salvogendut/picolino-CPC/docs/images/picolino-cpc-top.png

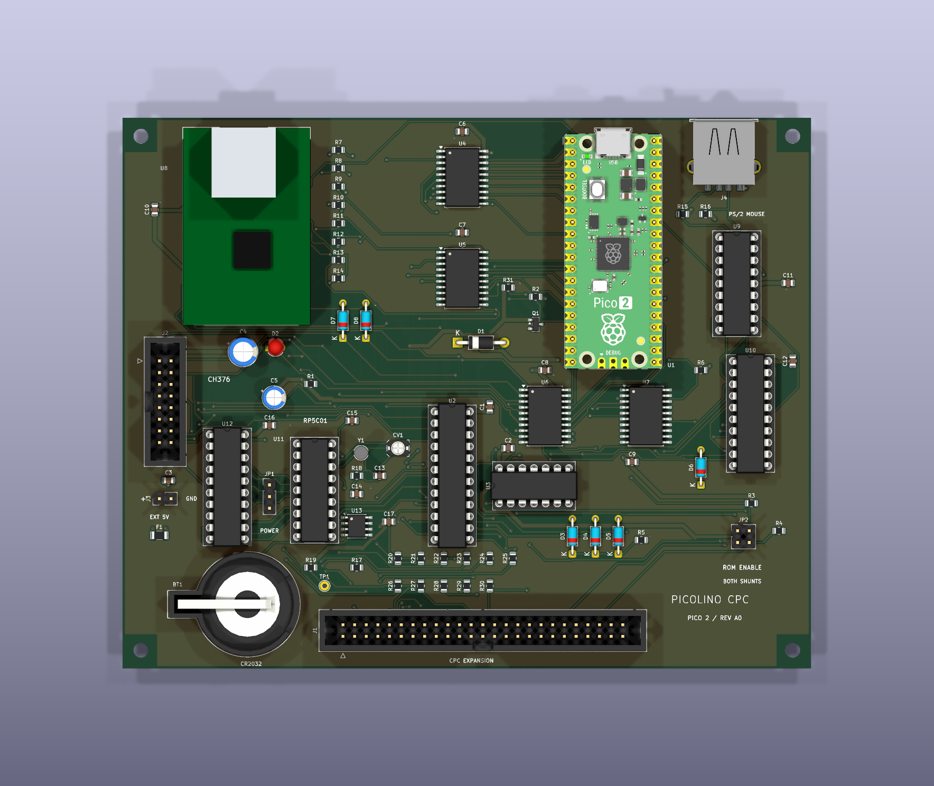
docs/images/picolino-cpc-top.png
