salvogendut/picolino-CPC/hardware/kicad/picolino-cpc-schematic.pdf

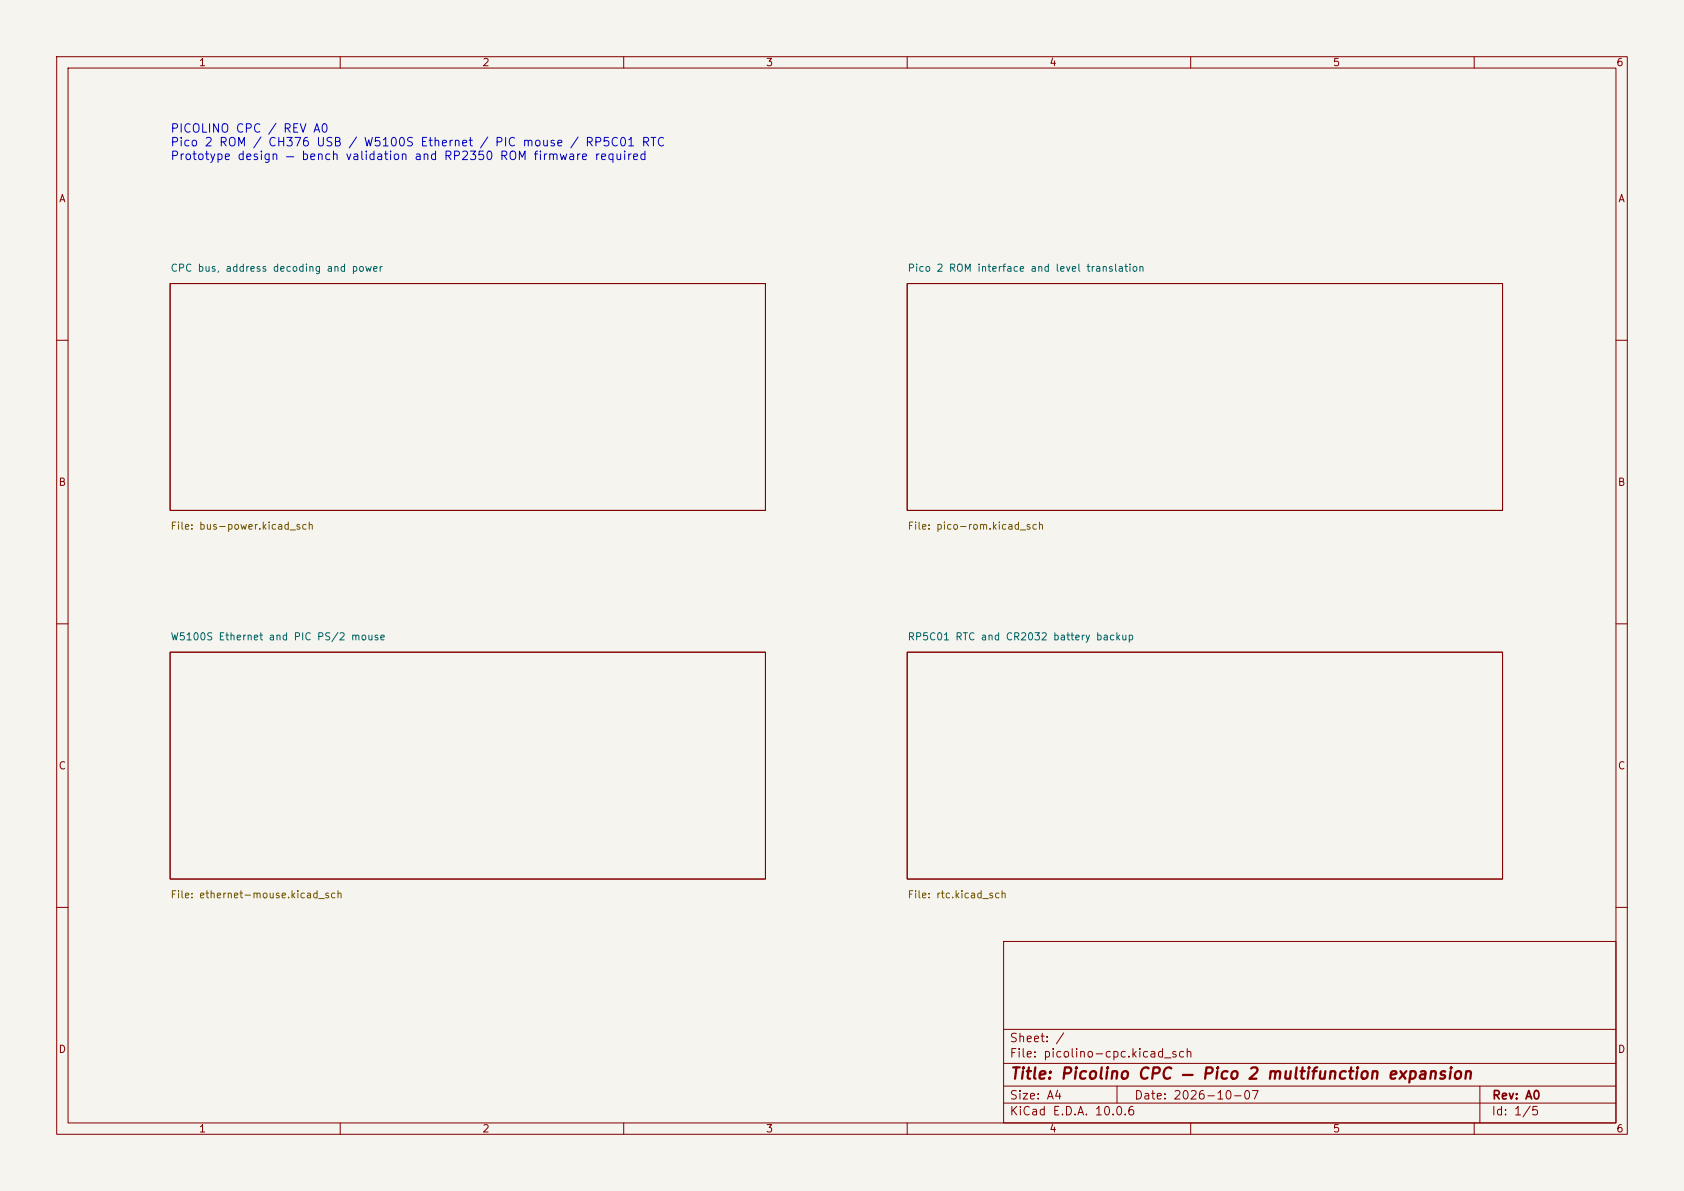
[picture p3: page 1]

PICOLINO CPC / REV A0
Pico 2 ROM / CH376 USB / W5100S Ethernet / PIC mouse / RP5C01 RTC
Prototype design — bench validation and RP2350 ROM firmware required

File: pico-rom.kicad_sch W5100S Ethernet and PIC PS/2 mouse

Sheet: /
File: picolino-cpc.kicad_sch
Title: Picolino CPC — Pico 2 multifunction expansion

Size: A4 | Rev: A0
KiCad E.D.A. 10.0.6 | Id: 1/5

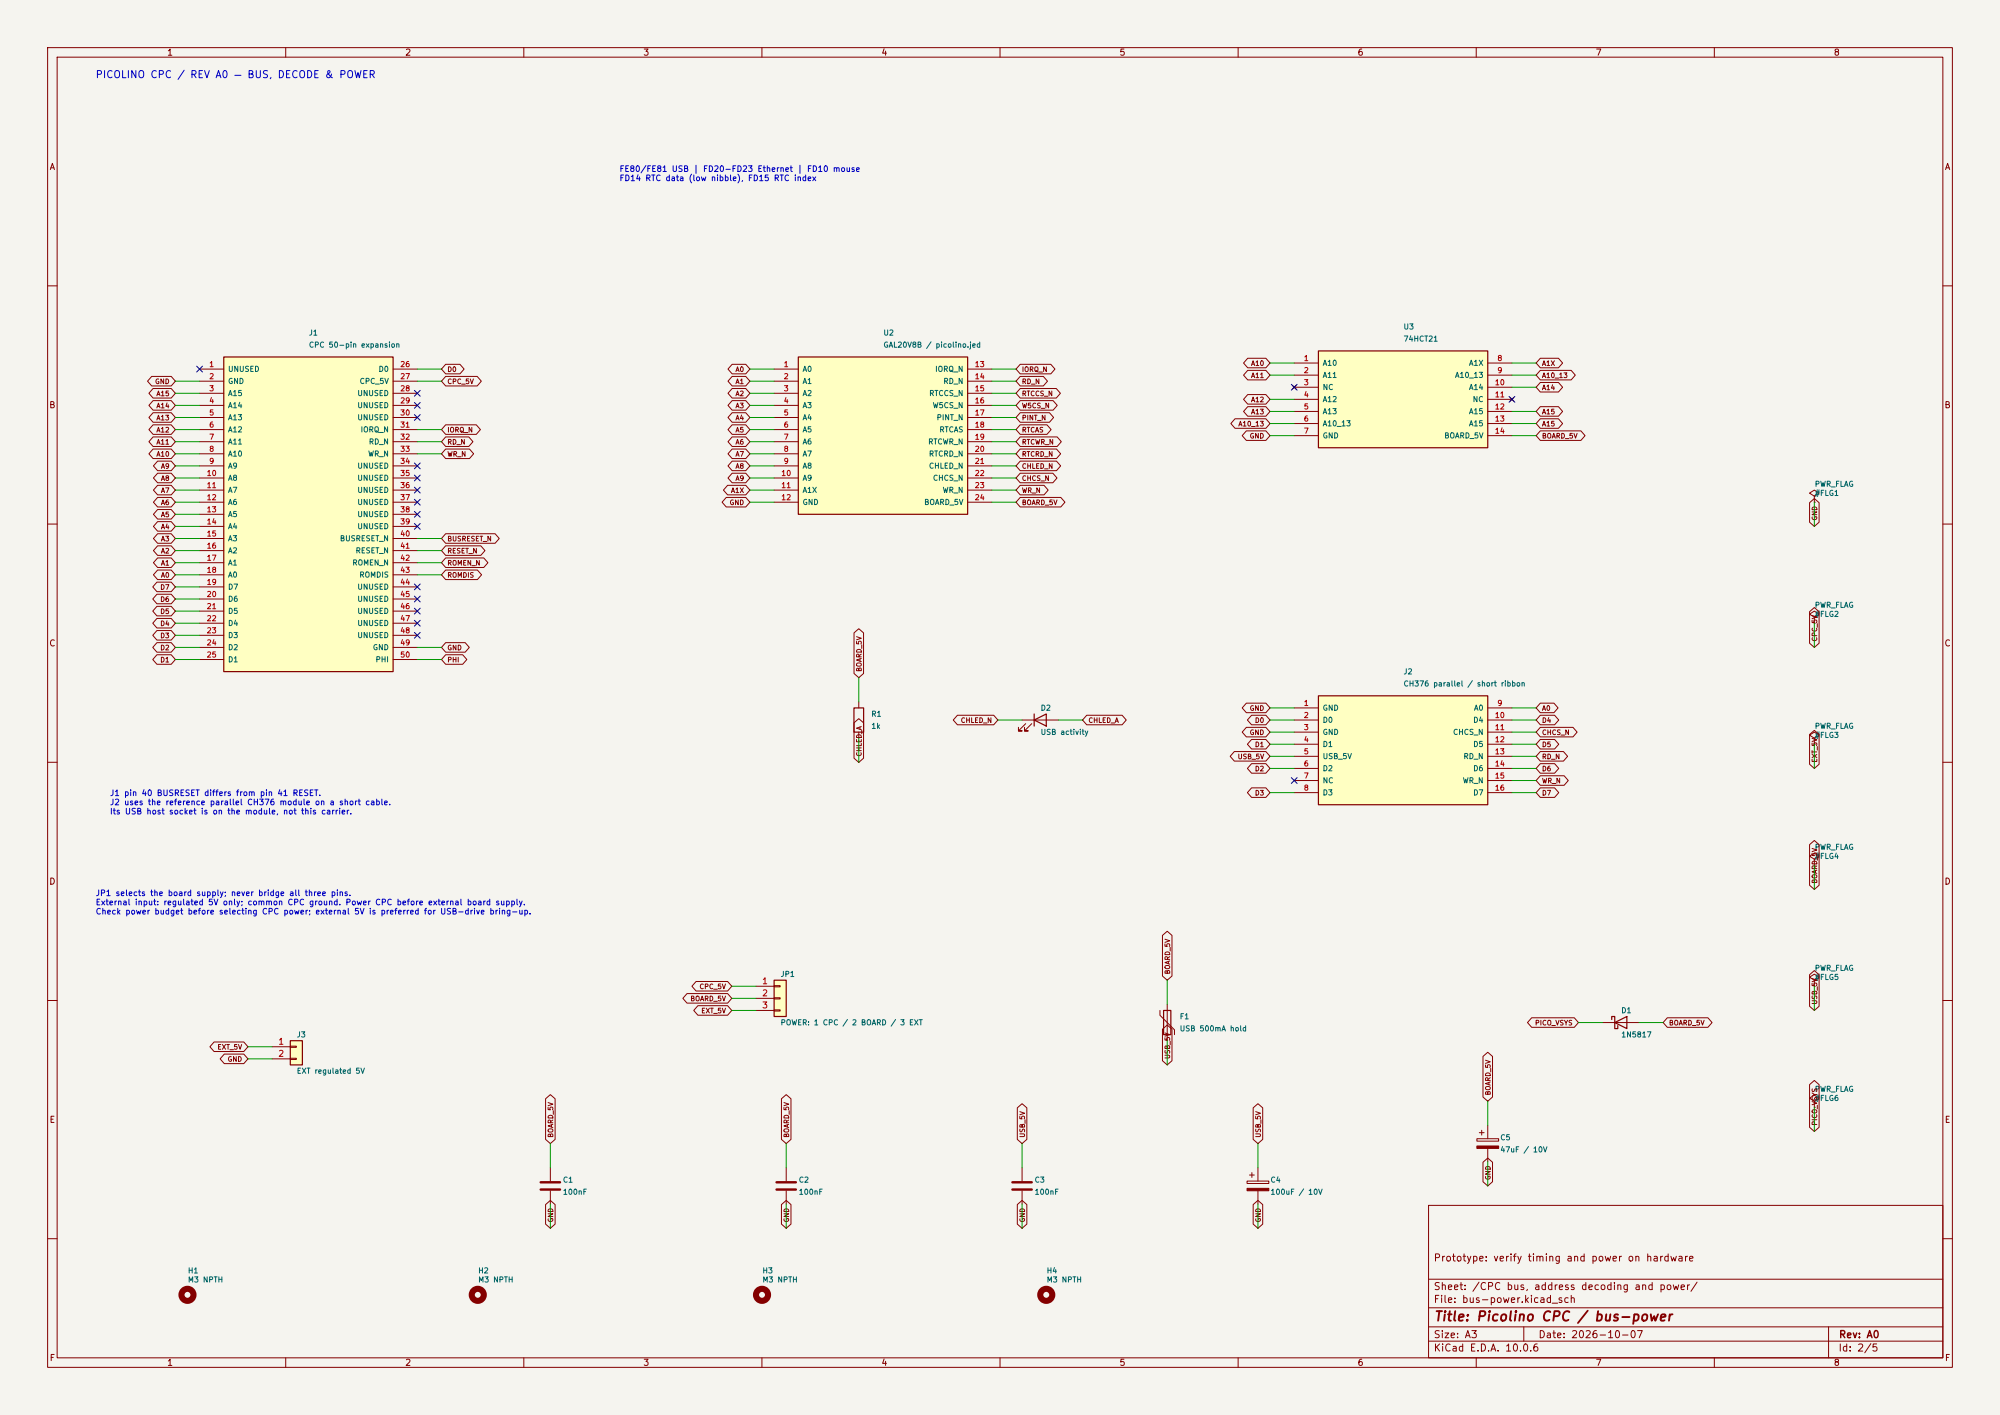
[picture p4: page 2]

PICOLINO CPC / REV A0 — BUS, DECODE & POWER

J1 pin 40 BUSRESET differs from pin 41 RESET. J2 uses the reference parallel CH376 module on a short cable.

Its USB host socket is on the module, not this carrier.

JP1 selects the board supply; never bridge all three pins. External input: regulated 5V only; common CPC ground. Power CPC before external board supply. Check power budget before selecting CPC power; external 5V is preferred for USB-drive bring-up.

Prototype: verify timing and power on hardware

Sheet: /CPC bus, address decoding and power/
File: bus-power.kicad_sch
Title: Picolino CPC / bus-power

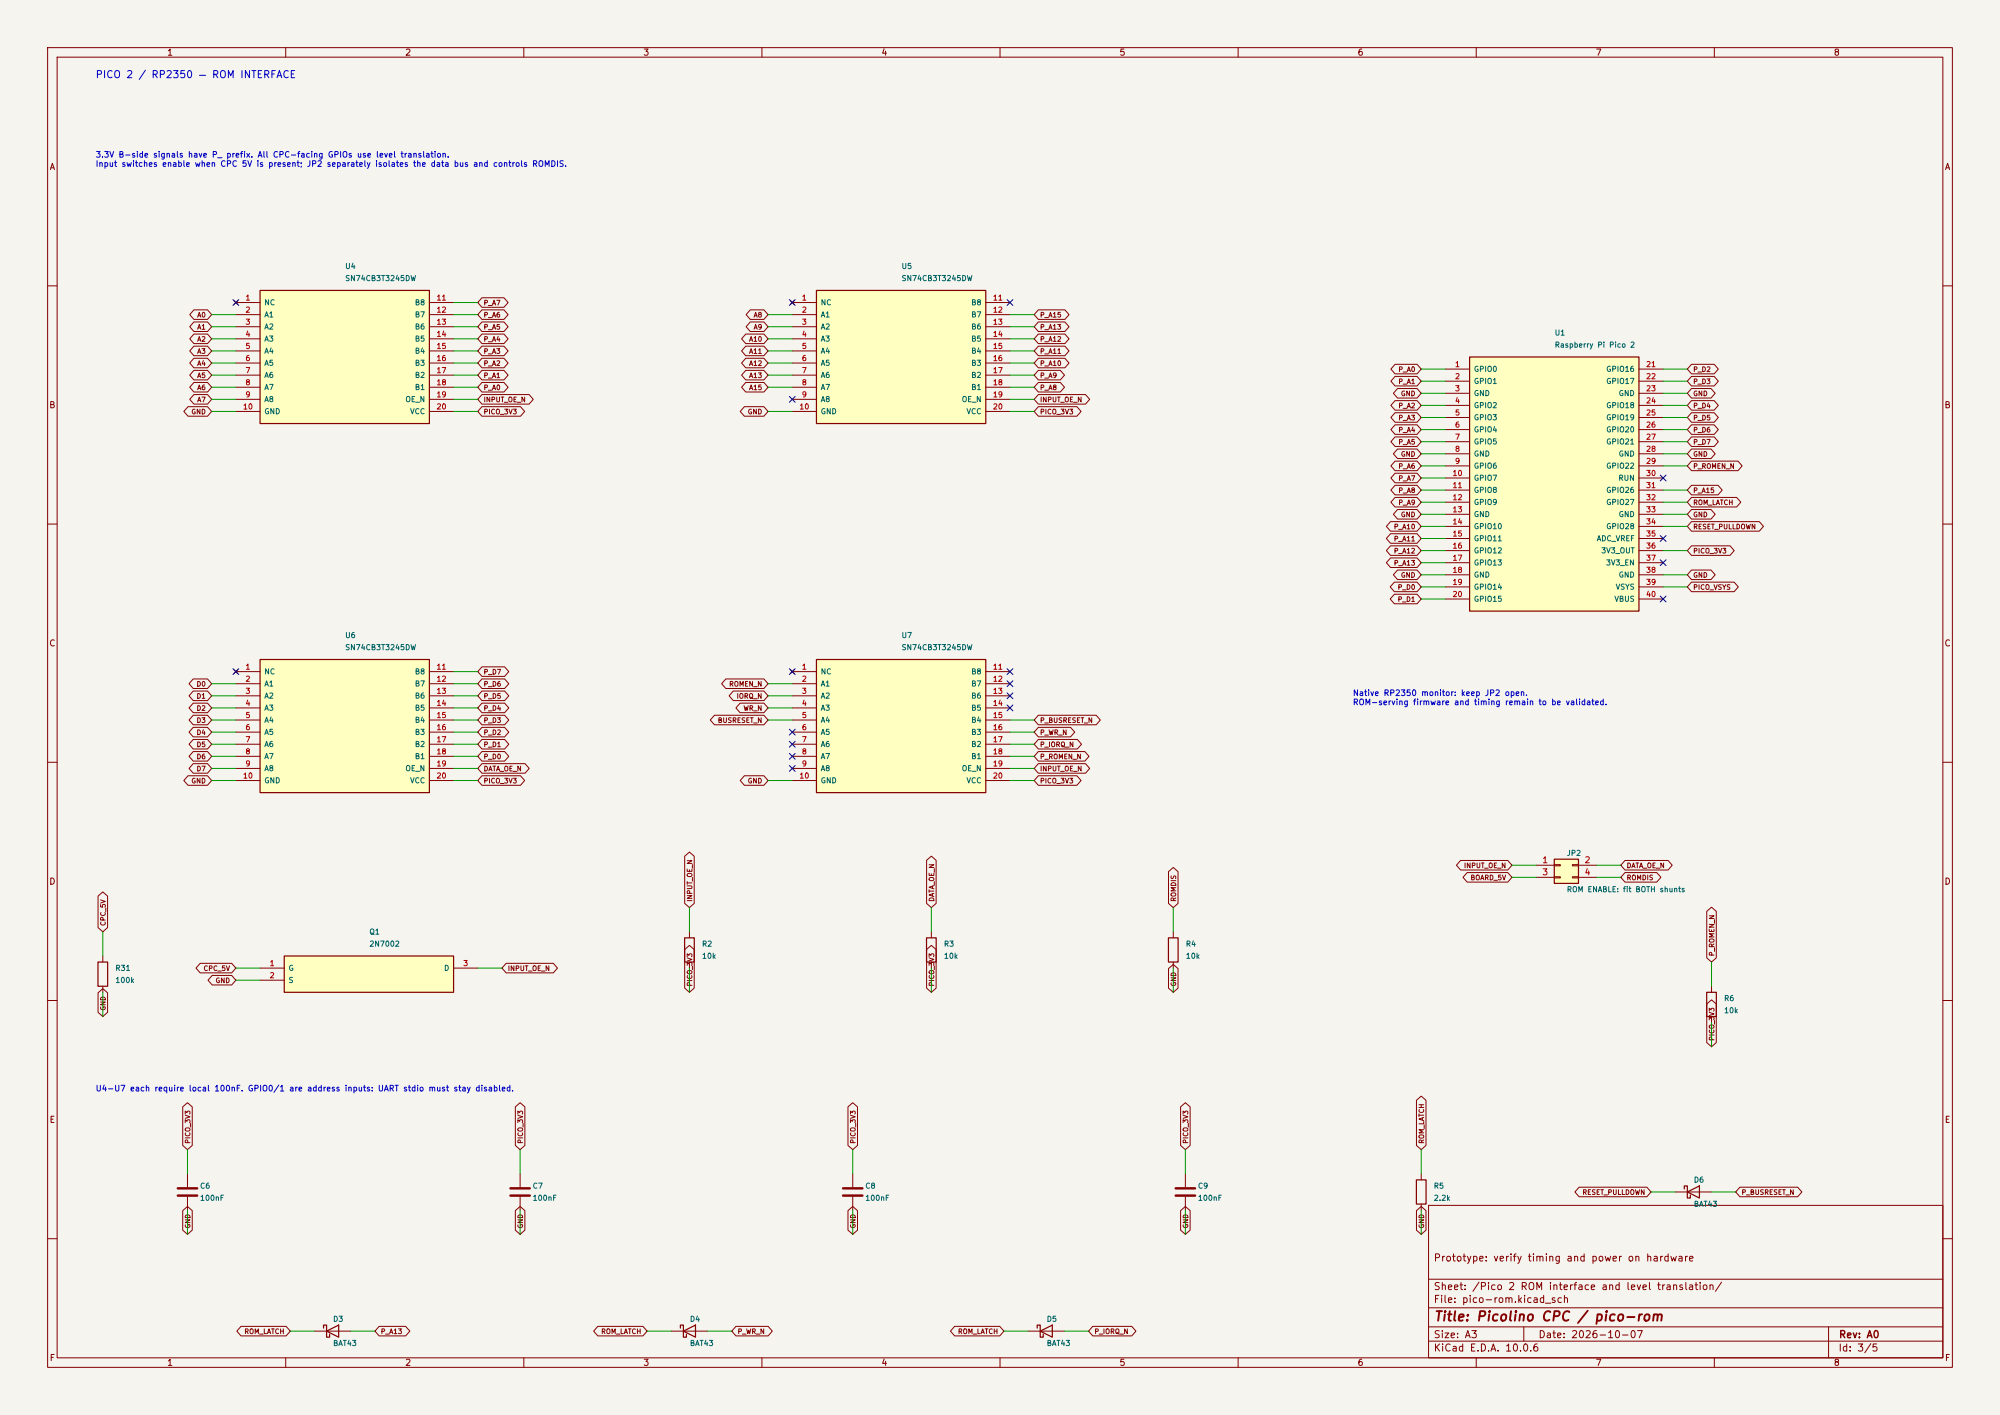
[picture p5: page 3]

Input switches enable when CPC 5V is present; JP2 separately isolates the data bus and controls ROMDIS. PICO 2 / RP2350 — ROM INTERFACE

RESET_PULLDOWN 3.3V B-side signals have P_ prefix. All CPC-facing GPIOs use level translation.

D0D4D5D6D7 CPC_5V GND
Native RP2350 monitor: keep JP2 open. ROM-serving firmware and timing remain to be validated. U4-U7 each require local 100nF. GPIO0/1 are address inputs: UART stdio must stay disabled.

JP2 ROM ENABLE: fit BOTH shunts

Prototype: verify timing and power on hardware

Sheet: /Pico 2 ROM interface and level translation/
File: pico-rom.kicad_sch
Title: Picolino CPC / pico-rom

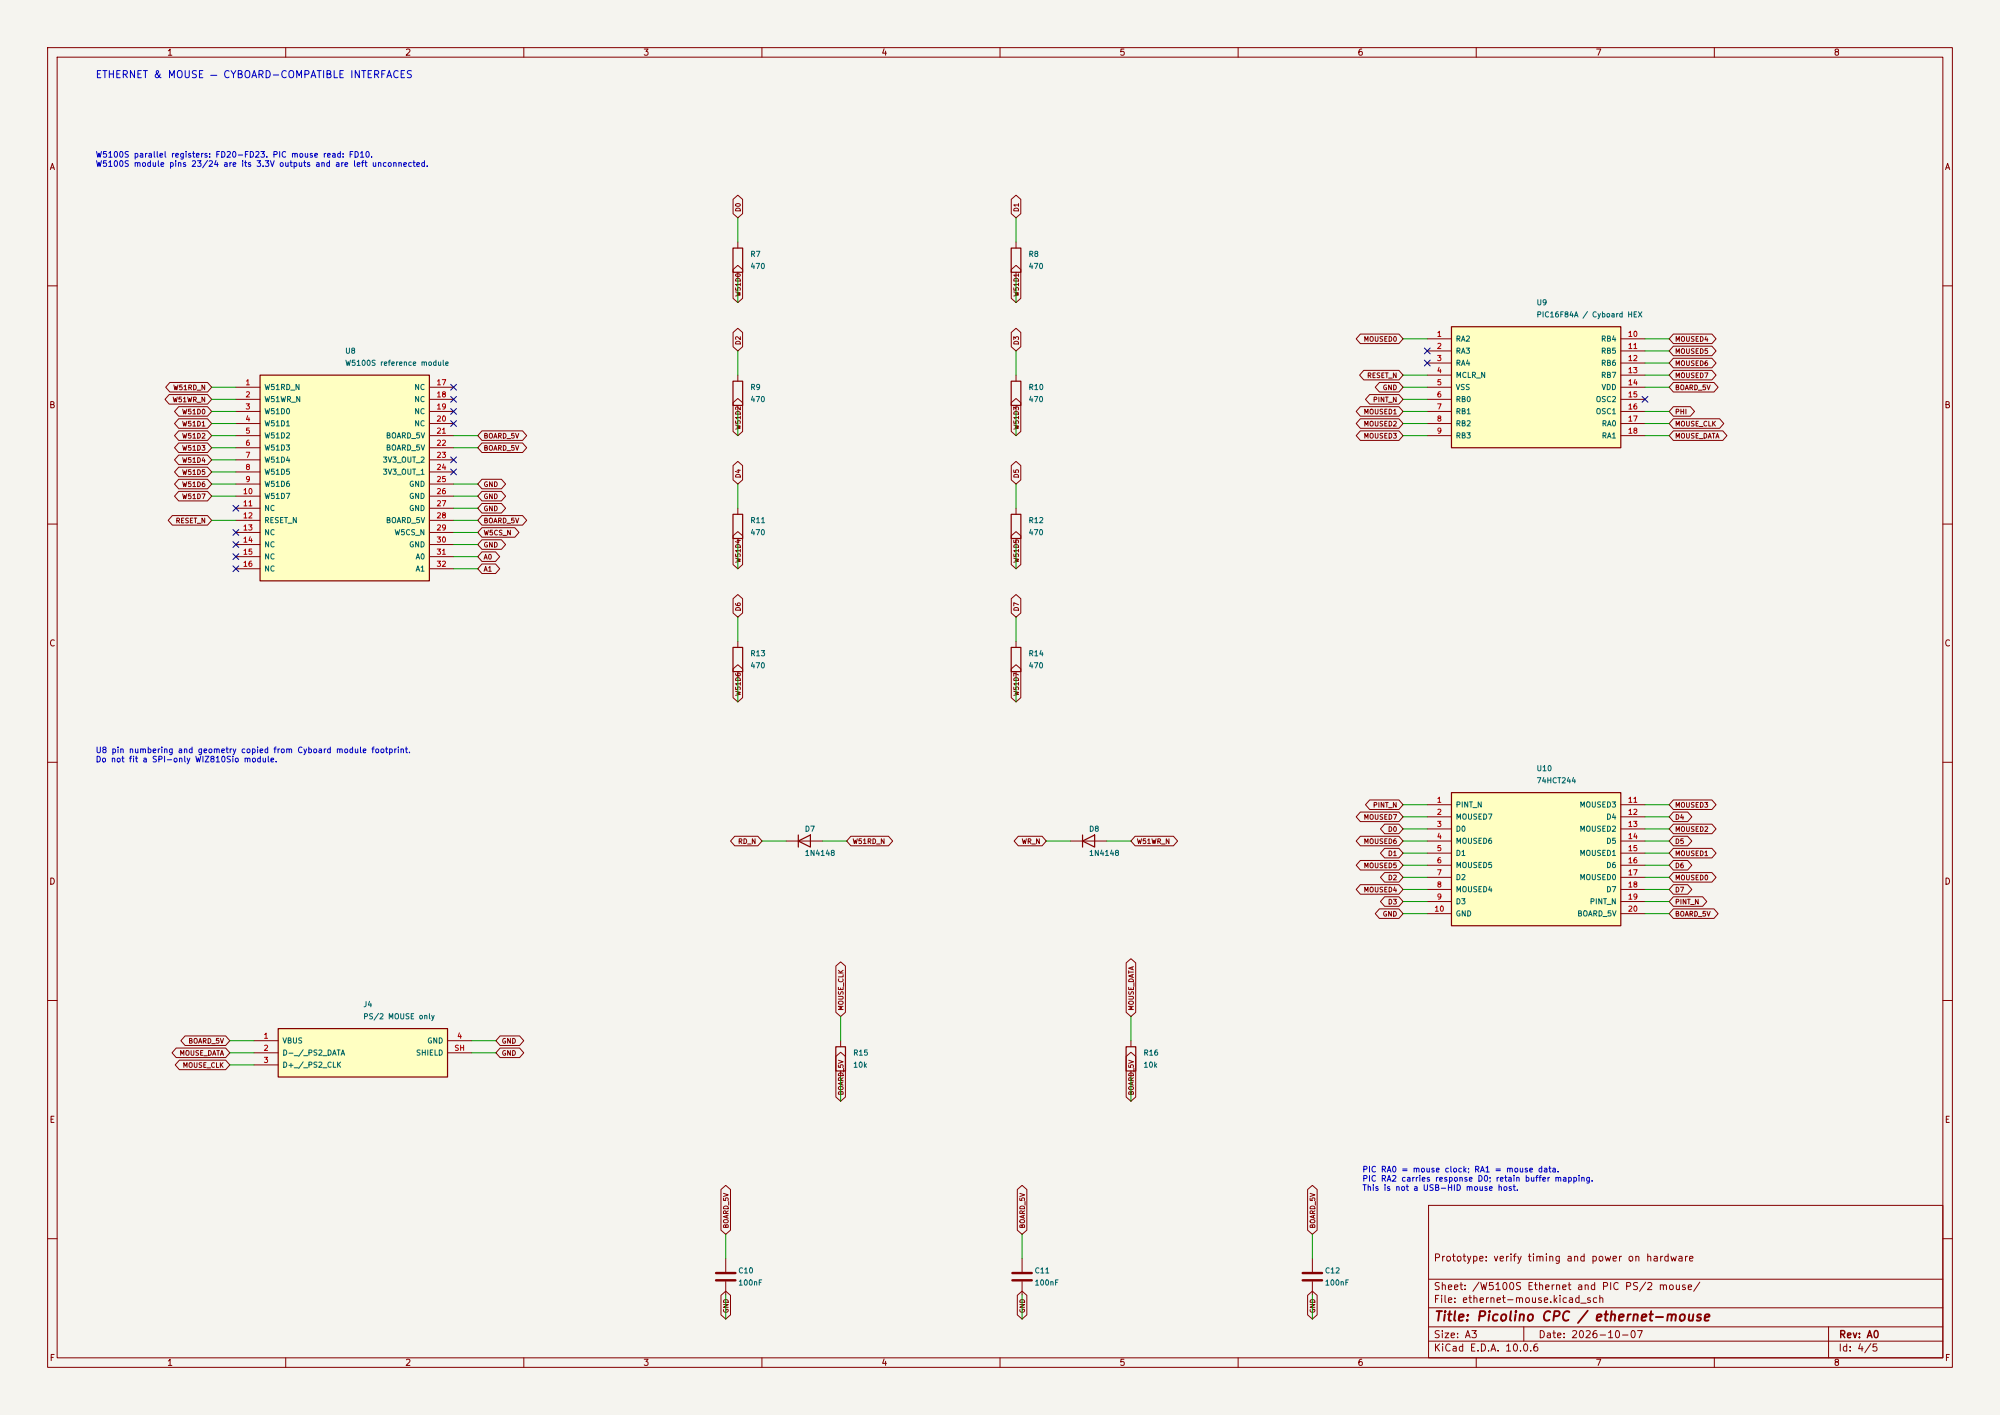
[picture p6: page 4]

ETHERNET & MOUSE — CYBOARD-COMPATIBLE INTERFACES

W5100S parallel registers: FD20-FD23. PIC mouse read: FD10. W5100S module pins 23/24 are its 3.3V outputs and are left unconnected.

Prototype: verify timing and power on hardware

Sheet: /W5100S Ethernet and PIC PS/2 mouse/
File: ethernet-mouse.kicad_sch
Title: Picolino CPC / ethernet-mouse

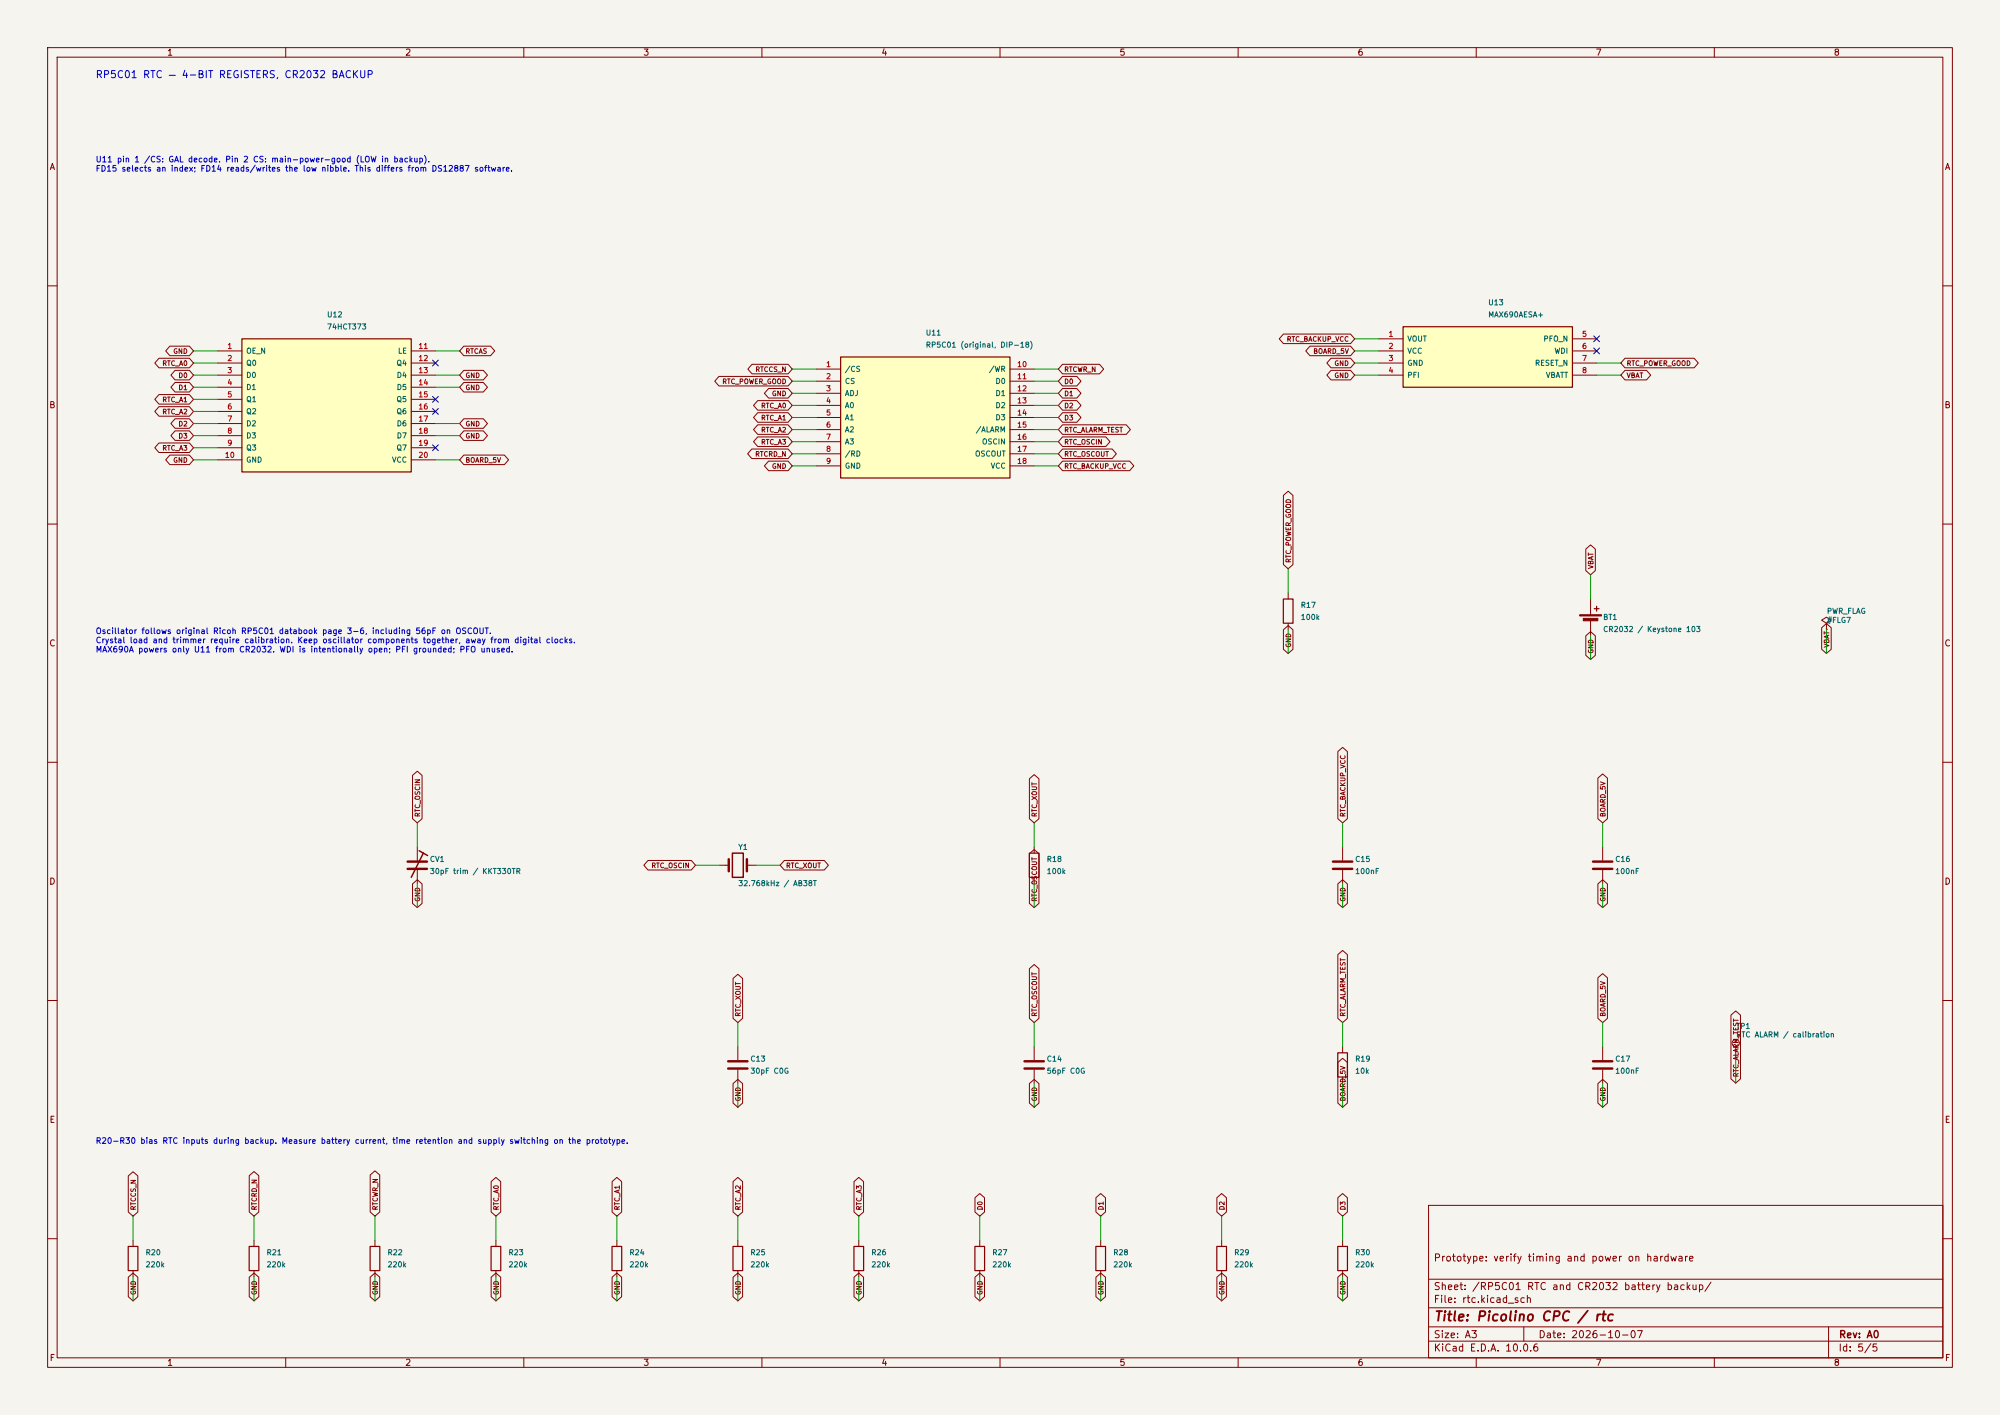
[picture p7: page 5]

RP5C01 RTC — 4-BIT REGISTERS, CR2032 BACKUP

U11 pin 1 /CS: GAL decode. Pin 2 CS: main-power-good (LOW in backup). FD15 selects an index; FD14 reads/writes the low nibble. This differs from DS12887 software.

Oscillator follows original Ricoh RP5C01 databook page 3-6, including 56pF on OSCOUT. Crystal load and trimmer require calibration. Keep oscillator components together, away from digital clocks. MAX690A powers only U11 from CR2032. WDI is intentionally open; PFI grounded; PFO unused.

R20-R30 bias RTC inputs during backup. Measure battery current, time retention and supply switching on the prototype.

Prototype: verify timing and power on hardware

Sheet: /RP5C01 RTC and CR2032 battery backup/
File: rtc.kicad_sch
Title: Picolino CPC / rtc
