salvogendut/picolino-CPC/hardware/kicad/picolino-cpc.kicad_pcb

## KiCad design hardware/kicad/picolino-cpc.kicad_pcb (2026-10-07)

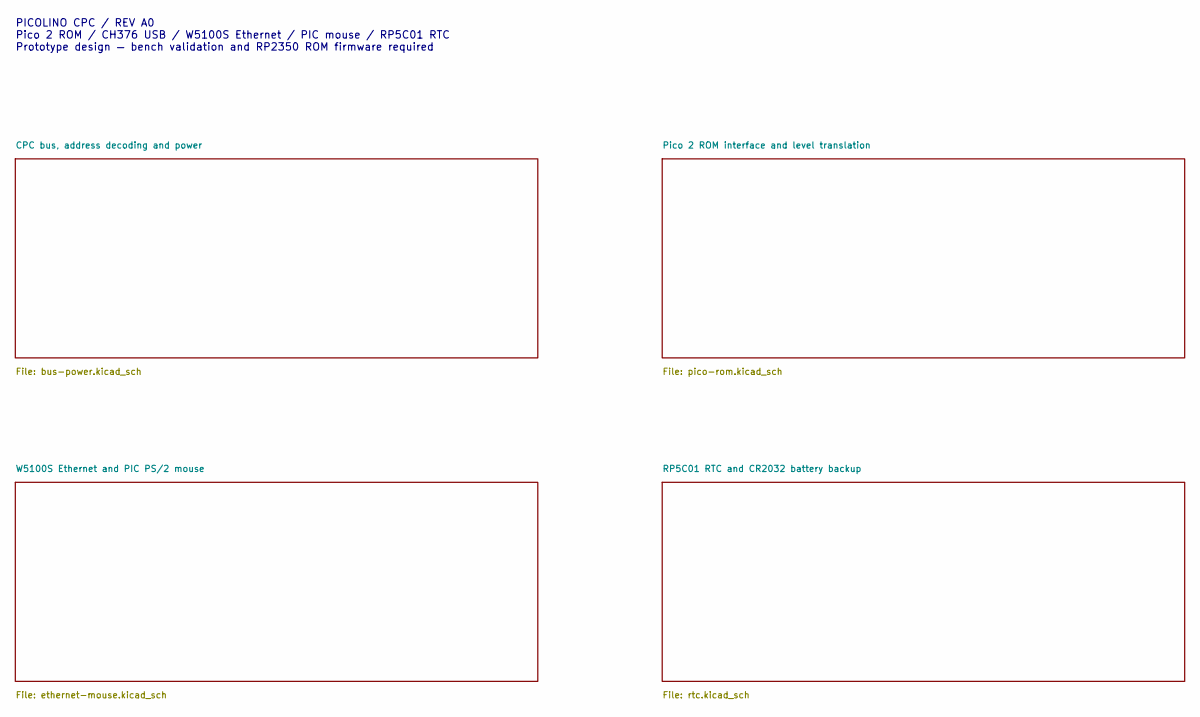
[picture p8: schematic picolino-cpc.kicad_sch, Picolino CPC — Pico 2 multifunction expansion]

Notes on the sheet:
PICOLINO CPC / REV A0 Pico 2 ROM / CH376 USB / W5100S Ethernet / PIC mouse / RP5C01 RTC Prototype design — bench validation and RP2350 ROM firmware required

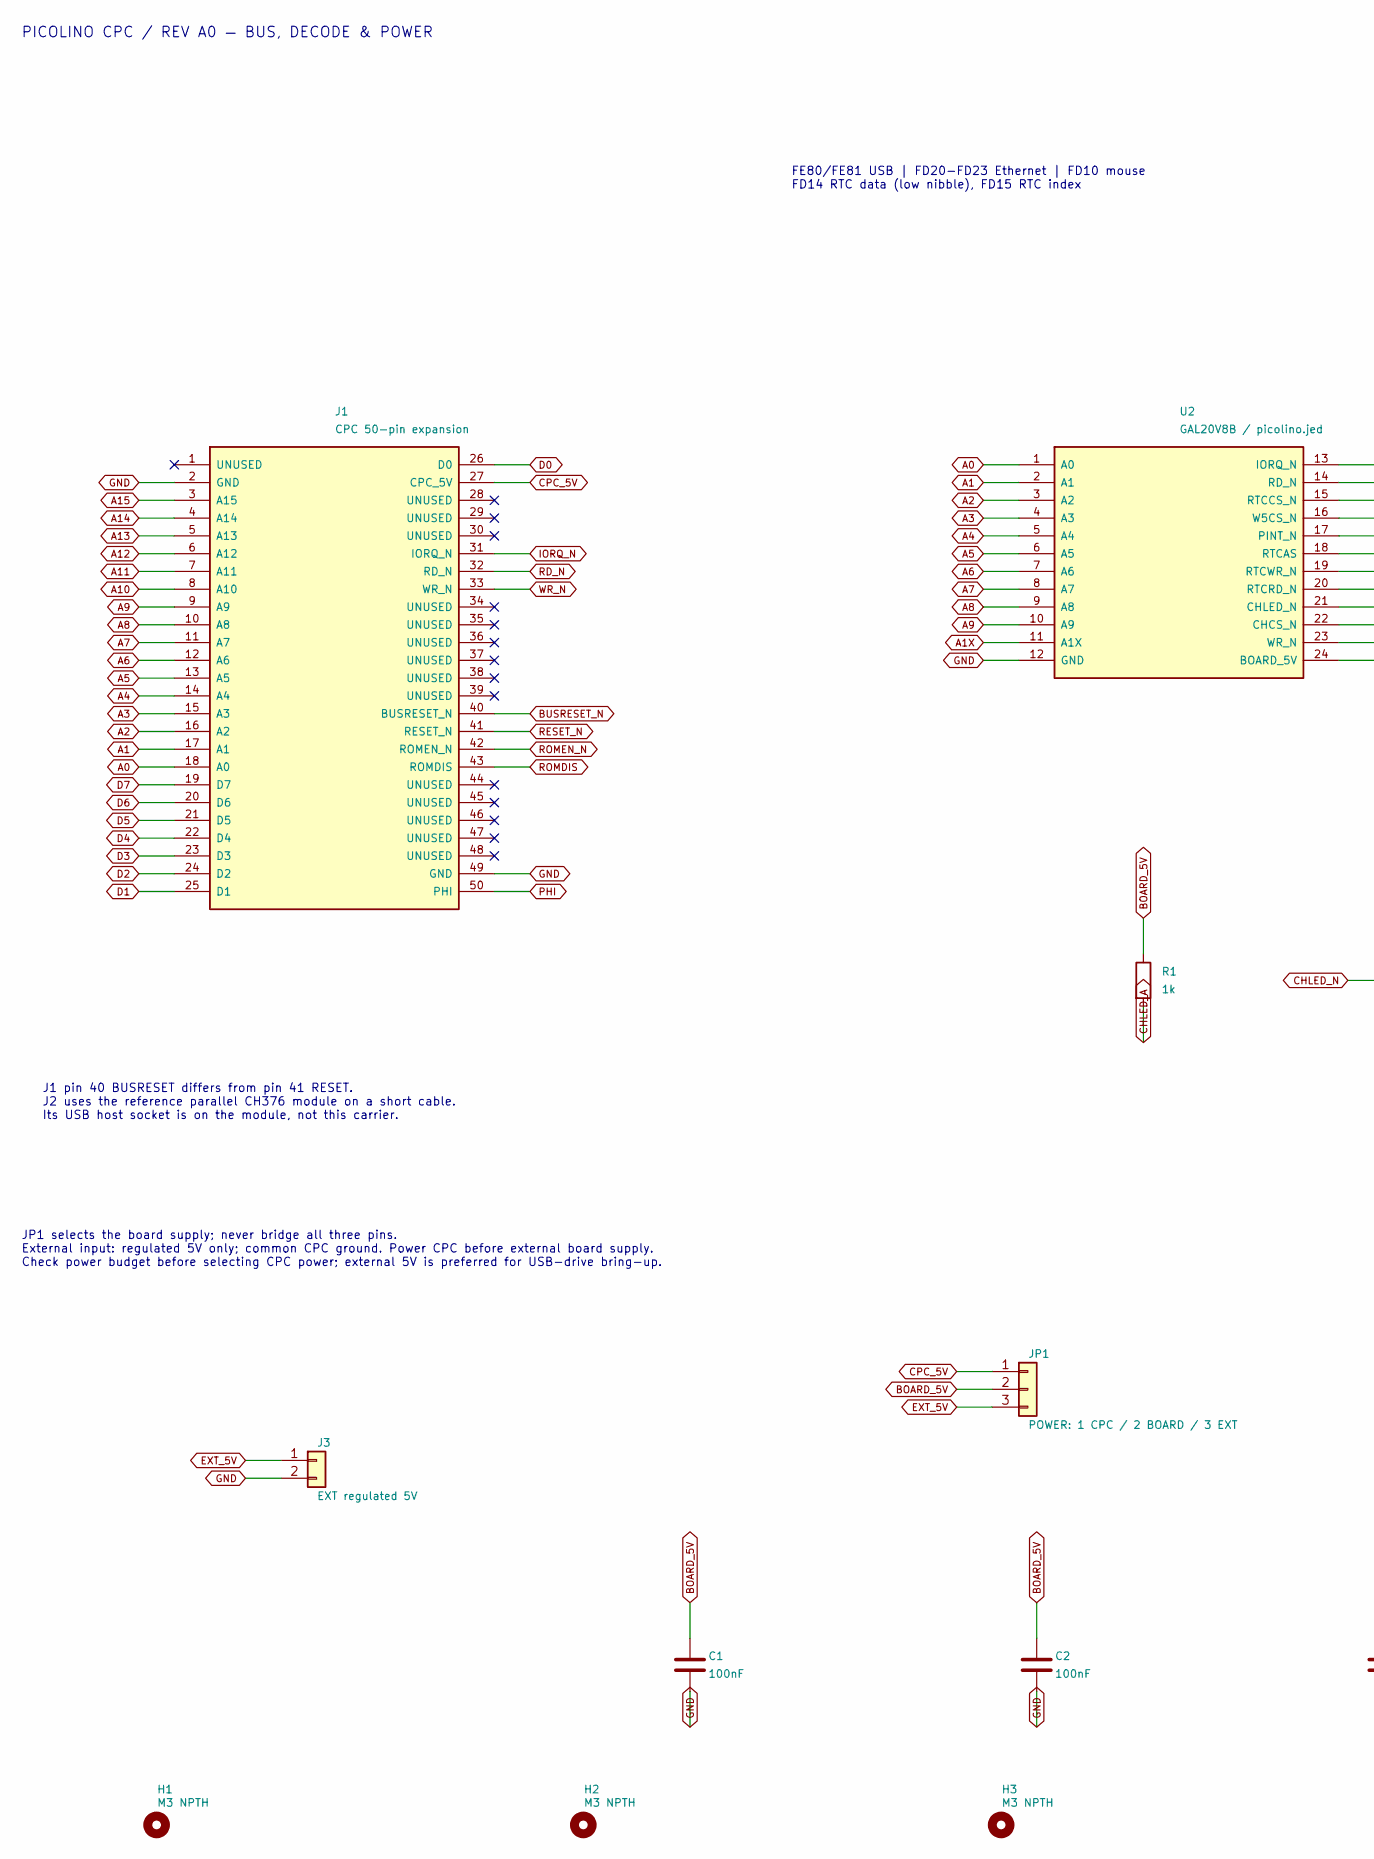
[picture p9: schematic bus-power.kicad_sch, Picolino CPC / bus-power, part in row 1, column 1]

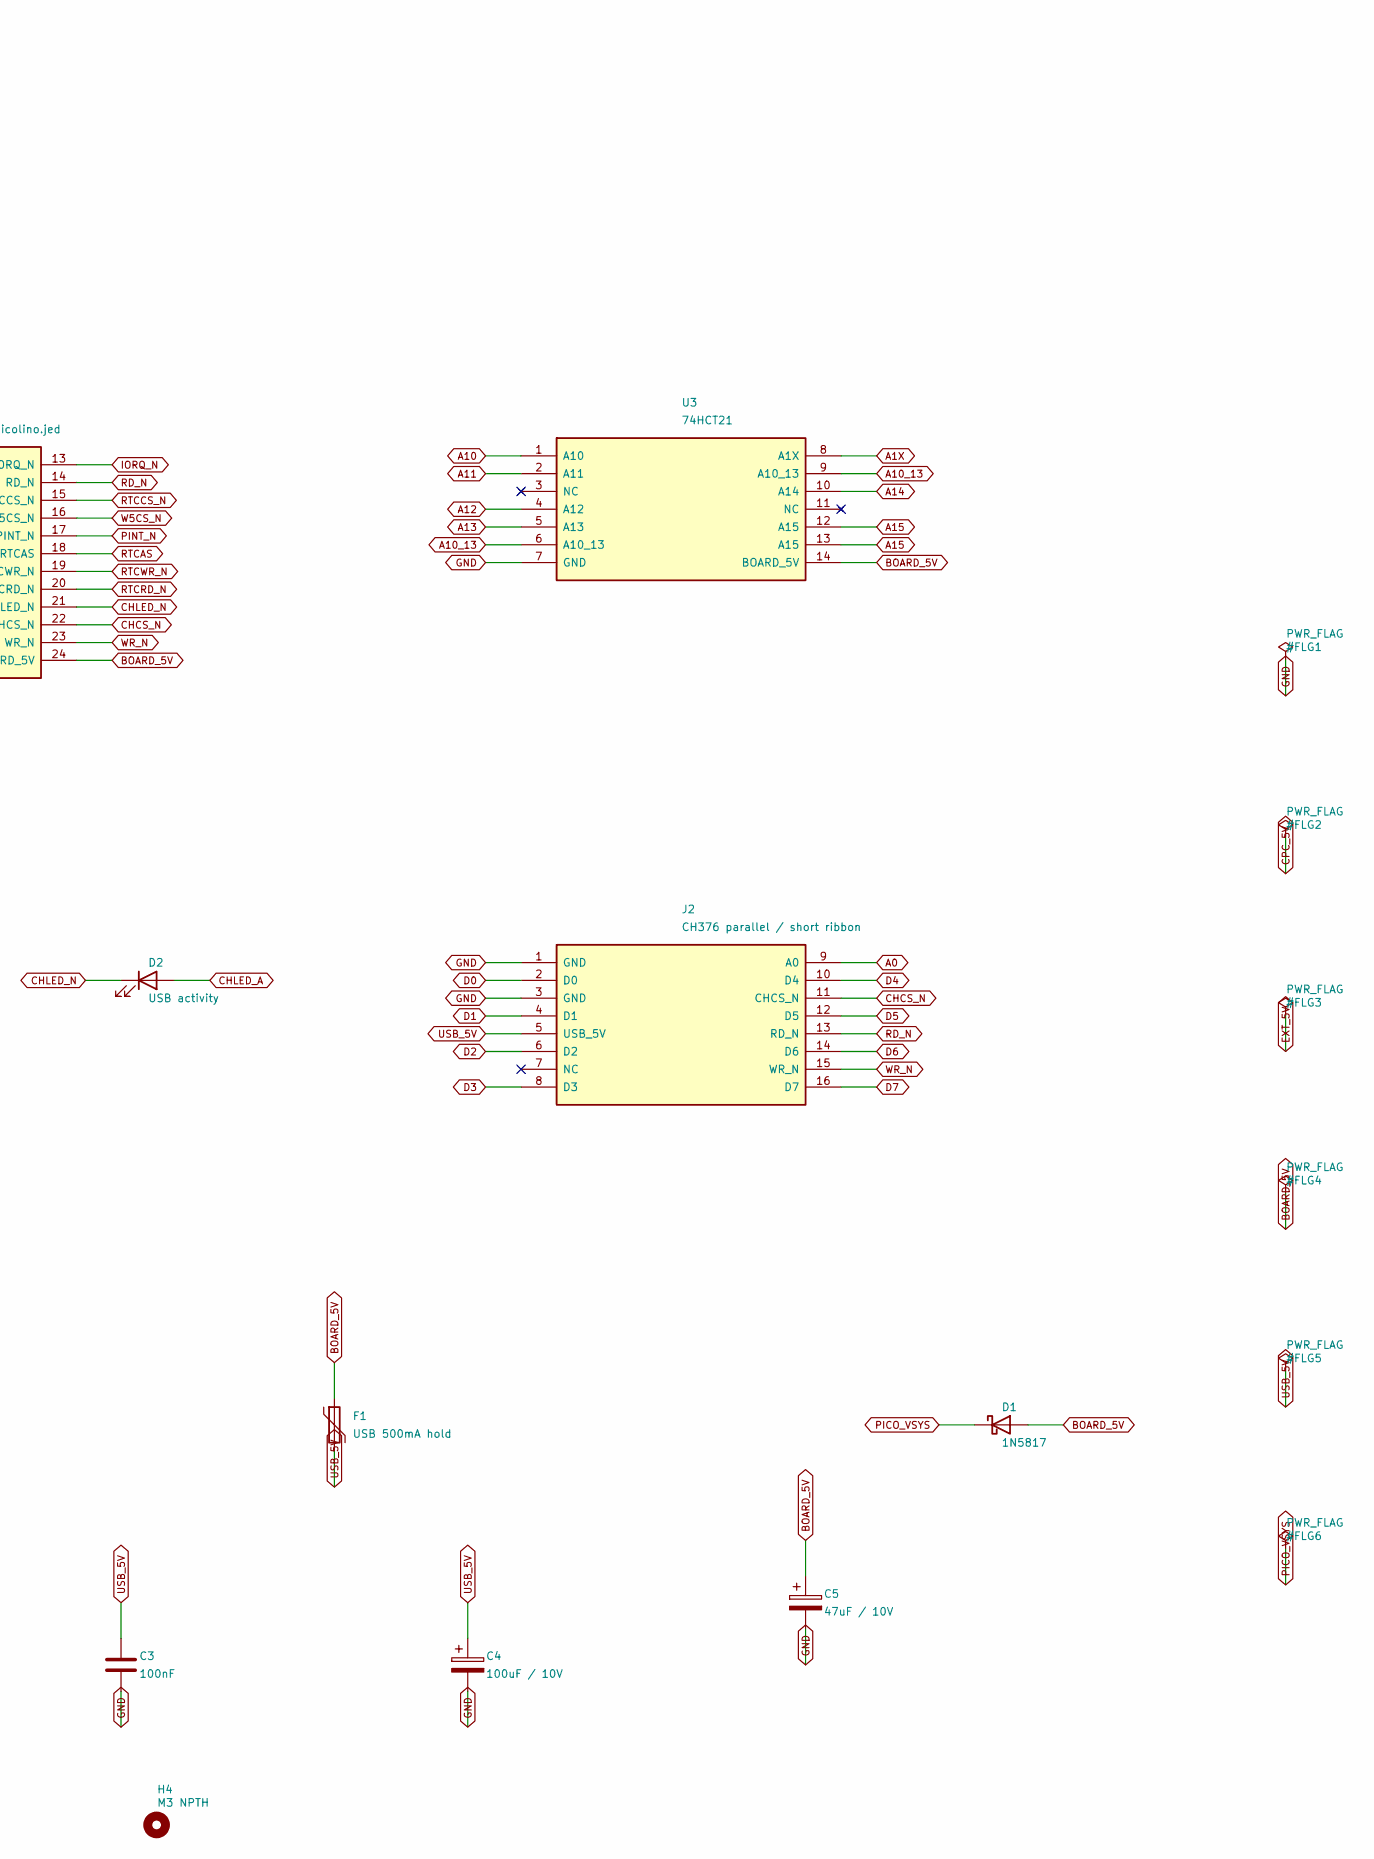
[picture p10: schematic bus-power.kicad_sch, Picolino CPC / bus-power, part in row 1, column 2]

Parts:
C1, C2, C3: 100nF; C_0805_2012Metric
C4: 100uF / 10V; CP_Radial_D6.3mm_P2.50mm
C5: 47uF / 10V; CP_Radial_D5.0mm_P2.00mm
D1: 1N5817; D_DO-41_SOD81_P10.16mm_Horizontal
D2: USB activity; LED_D3.0mm
F1: USB 500mA hold; Fuse_1206_3216Metric
H1, H2, H3, H4: M3 NPTH; MountingHole_3.2mm_M3
J1: CPC 50-pin expansion; IDC-Header_2x25_P2.54mm_Vertical
J2: CH376 parallel / short ribbon; IDC-Header_2x08_P2.54mm_Vertical
J3: EXT regulated 5V; PinHeader_1x02_P2.54mm_Vertical
JP1: POWER: 1 CPC / 2 BOARD / 3 EXT; PinHeader_1x03_P2.54mm_Vertical
R1: 1k; R_0805_2012Metric
U2: GAL20V8B / picolino.jed; DIP-24_W7.62mm_Socket_LongPads
U3: 74HCT21; DIP-14_W7.62mm_Socket_LongPads

Connections:
A0: J1.18 (A0), J2.9 (A0), U2.1 (A0); also elsewhere on the board
A1: J1.17 (A1), U2.2 (A1); also elsewhere on the board
A1X: U2.11 (A1X), U3.8 (A1X)
A2: J1.16 (A2), U2.3 (A2); also elsewhere on the board
A3: J1.15 (A3), U2.4 (A3); also elsewhere on the board
A4: J1.14 (A4), U2.5 (A4); also elsewhere on the board
A5: J1.13 (A5), U2.6 (A5); also elsewhere on the board
A6: J1.12 (A6), U2.7 (A6); also elsewhere on the board
A7: J1.11 (A7), U2.8 (A7); also elsewhere on the board
A8: J1.10 (A8), U2.9 (A8); also elsewhere on the board
A9: J1.9 (A9), U2.10 (A9); also elsewhere on the board
A10: J1.8 (A10), U3.1 (A10); also elsewhere on the board
A10_13: U3.6 (A10_13), U3.9 (A10_13)
A11: J1.7 (A11), U3.2 (A11); also elsewhere on the board
A12: J1.6 (A12), U3.4 (A12); also elsewhere on the board
A13: J1.5 (A13), U3.5 (A13); also elsewhere on the board
A14: J1.4 (A14), U3.10 (A14)
A15: J1.3 (A15), U3.12 (A15), U3.13 (A15); also elsewhere on the board
BOARD_5V: C1.1, C2.1, C5.1, D1.2 (A), F1.1, JP1.2, R1.1, U2.24 (BOARD_5V), U3.14 (BOARD_5V); also elsewhere on the board
BUSRESET_N: J1.40 (BUSRESET_N); also elsewhere on the board
CHCS_N: J2.11 (CHCS_N), U2.22 (CHCS_N)
CHLED_A: D2.2 (A), R1.2
CHLED_N: D2.1 (K), U2.21 (CHLED_N)
CPC_5V: J1.27 (CPC_5V), JP1.1; also elsewhere on the board
D0: J1.26 (D0), J2.2 (D0); also elsewhere on the board
D1: J1.25 (D1), J2.4 (D1); also elsewhere on the board
D2: J1.24 (D2), J2.6 (D2); also elsewhere on the board
D3: J1.23 (D3), J2.8 (D3); also elsewhere on the board
D4: J1.22 (D4), J2.10 (D4); also elsewhere on the board
D5: J1.21 (D5), J2.12 (D5); also elsewhere on the board
D6: J1.20 (D6), J2.14 (D6); also elsewhere on the board
D7: J1.19 (D7), J2.16 (D7); also elsewhere on the board
EXT_5V: J3.1, JP1.3
GND: C1.2, C2.2, C3.2, C4.2, C5.2, J1.2 (GND), J1.49 (GND), J2.1 (GND), J2.3 (GND), J3.2, U2.12 (GND), U3.7 (GND); also elsewhere on the board
IORQ_N: J1.31 (IORQ_N), U2.13 (IORQ_N); also elsewhere on the board
PHI: J1.50 (PHI); also elsewhere on the board
PICO_VSYS: D1.1 (K); also elsewhere on the board
PINT_N: U2.17 (PINT_N); also elsewhere on the board
RD_N: J1.32 (RD_N), J2.13 (RD_N), U2.14 (RD_N); also elsewhere on the board
RESET_N: J1.41 (RESET_N); also elsewhere on the board
ROMDIS: J1.43 (ROMDIS); also elsewhere on the board
ROMEN_N: J1.42 (ROMEN_N); also elsewhere on the board
RTCAS: U2.18 (RTCAS); also elsewhere on the board
RTCCS_N: U2.15 (RTCCS_N); also elsewhere on the board
RTCRD_N: U2.20 (RTCRD_N); also elsewhere on the board
RTCWR_N: U2.19 (RTCWR_N); also elsewhere on the board
USB_5V: C3.1, C4.1, F1.2, J2.5 (USB_5V)
W5CS_N: U2.16 (W5CS_N); also elsewhere on the board
WR_N: J1.33 (WR_N), J2.15 (WR_N), U2.23 (WR_N); also elsewhere on the board

Notes on the sheet:
PICOLINO CPC / REV A0 — BUS, DECODE & POWER
FE80/FE81 USB | FD20-FD23 Ethernet | FD10 mouse FD14 RTC data (low nibble), FD15 RTC index
J1 pin 40 BUSRESET differs from pin 41 RESET. J2 uses the reference parallel CH376 module on a short cable. Its USB host socket is on the module, not this carrier.
JP1 selects the board supply; never bridge all three pins. External input: regulated 5V only; common CPC ground. Power CPC before external board supply. Check power budget before selecting CPC power; external 5V is preferred for USB-drive bring-up.

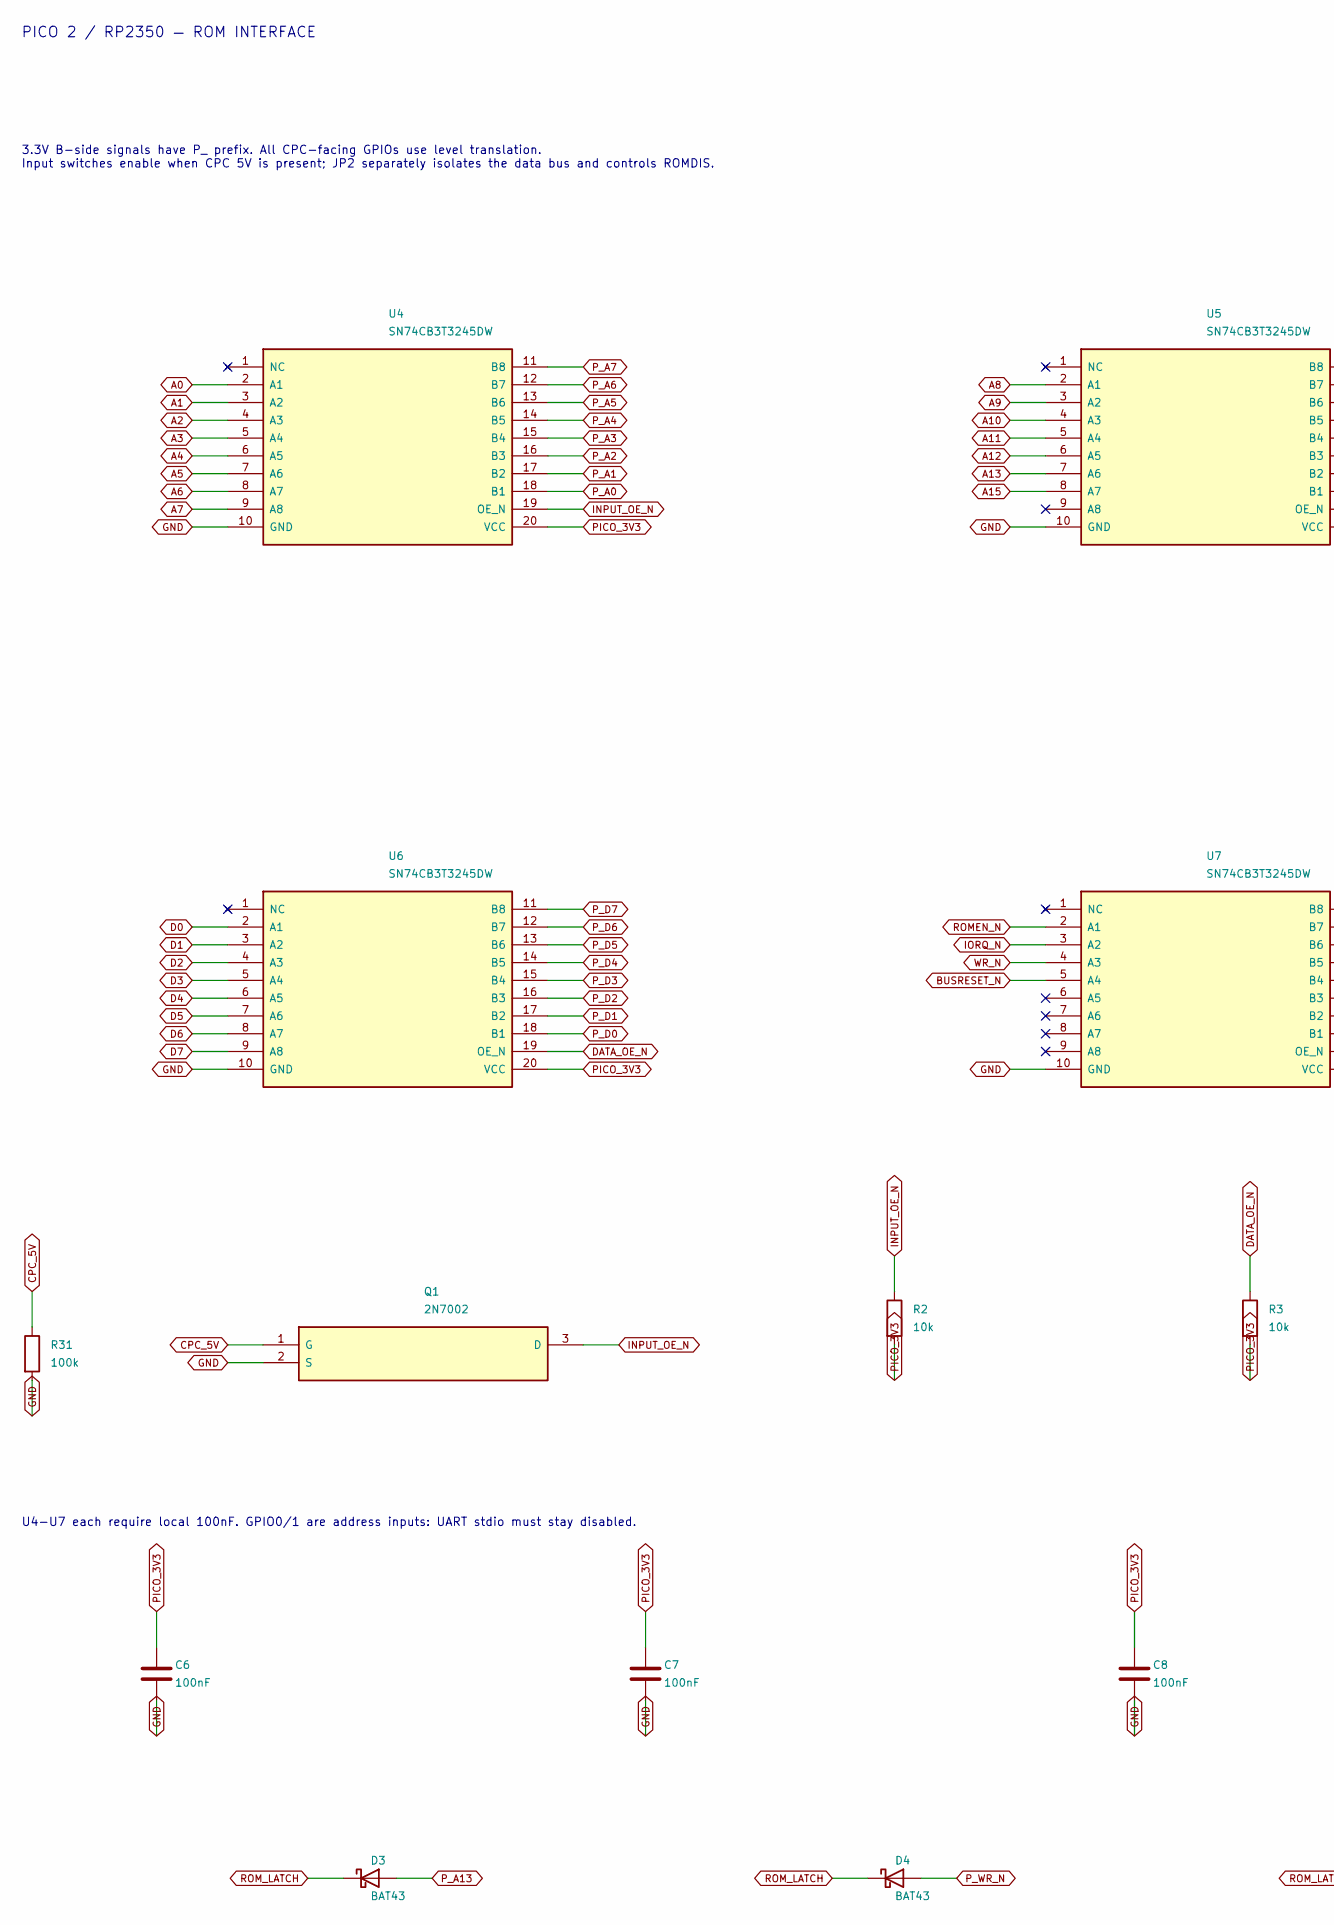
[picture p11: schematic pico-rom.kicad_sch, Picolino CPC / pico-rom, part in row 1, column 1]

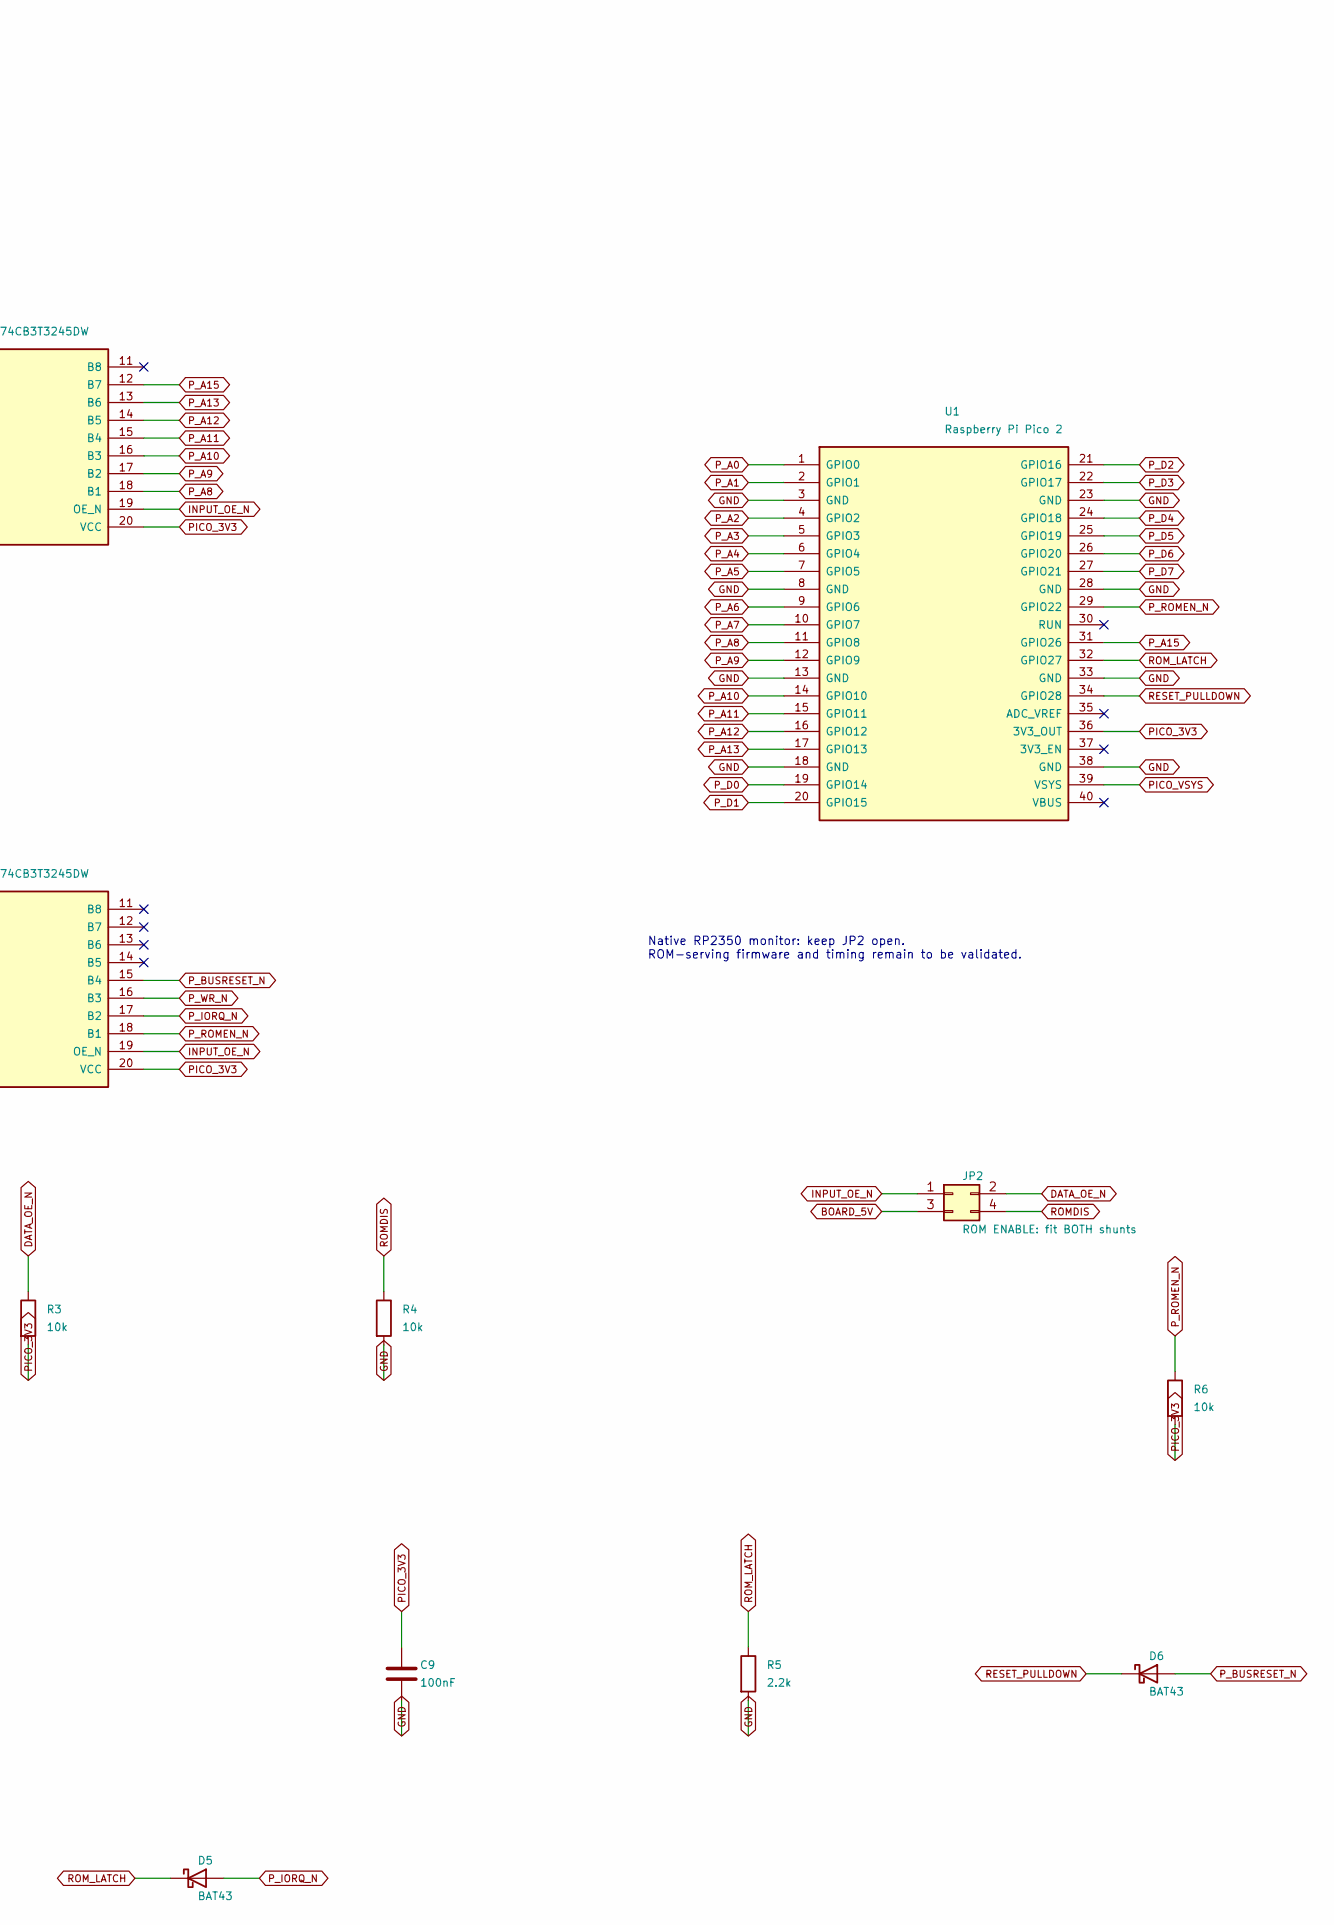
[picture p12: schematic pico-rom.kicad_sch, Picolino CPC / pico-rom, part in row 1, column 2]

Parts:
C6, C7, C8, C9: 100nF; C_0805_2012Metric
D3, D4, D5, D6: BAT43; D_DO-35_SOD27_P7.62mm_Horizontal
JP2: ROM ENABLE: fit BOTH shunts; PinHeader_2x02_P2.54mm_Vertical
Q1: 2N7002; SOT-23
R2, R3, R4, R6: 10k; R_0805_2012Metric
R5: 2.2k; R_0805_2012Metric
R31: 100k; R_0805_2012Metric
U1: Raspberry Pi Pico 2; Pico2_Socketed
U4, U5, U6, U7: SN74CB3T3245DW; SOIC-20W_7.5x12.8mm_P1.27mm

Connections:
A0: U4.2 (A1); also elsewhere on the board
A1: U4.3 (A2); also elsewhere on the board
A2: U4.4 (A3); also elsewhere on the board
A3: U4.5 (A4); also elsewhere on the board
A4: U4.6 (A5); also elsewhere on the board
A5: U4.7 (A6); also elsewhere on the board
A6: U4.8 (A7); also elsewhere on the board
A7: U4.9 (A8); also elsewhere on the board
A8: U5.2 (A1); also elsewhere on the board
A9: U5.3 (A2); also elsewhere on the board
A10: U5.4 (A3); also elsewhere on the board
A11: U5.5 (A4); also elsewhere on the board
A12: U5.6 (A5); also elsewhere on the board
A13: U5.7 (A6); also elsewhere on the board
A15: U5.8 (A7); also elsewhere on the board
BOARD_5V: JP2.3; also elsewhere on the board
BUSRESET_N: U7.5 (A4); also elsewhere on the board
CPC_5V: Q1.1 (G), R31.1; also elsewhere on the board
D0: U6.2 (A1); also elsewhere on the board
D1: U6.3 (A2); also elsewhere on the board
D2: U6.4 (A3); also elsewhere on the board
D3: U6.5 (A4); also elsewhere on the board
D4: U6.6 (A5); also elsewhere on the board
D5: U6.7 (A6); also elsewhere on the board
D6: U6.8 (A7); also elsewhere on the board
D7: U6.9 (A8); also elsewhere on the board
DATA_OE_N: JP2.2, R3.1, U6.19 (OE_N)
GND: C6.2, C7.2, C8.2, C9.2, Q1.2 (S), R4.2, R5.2, R31.2, U1.3 (GND), U1.8 (GND), U1.13 (GND), U1.18 (GND), U1.23 (GND), U1.28 (GND), U1.33 (GND), U1.38 (GND), U4.10 (GND), U5.10 (GND), U6.10 (GND), U7.10 (GND); also elsewhere on the board
INPUT_OE_N: JP2.1, Q1.3 (D), R2.1, U4.19 (OE_N), U5.19 (OE_N), U7.19 (OE_N)
IORQ_N: U7.3 (A2); also elsewhere on the board
PICO_3V3: C6.1, C7.1, C8.1, C9.1, R2.2, R3.2, R6.2, U1.36 (3V3_OUT), U4.20 (VCC), U5.20 (VCC), U6.20 (VCC), U7.20 (VCC)
PICO_VSYS: U1.39 (VSYS); also elsewhere on the board
P_A0: U1.1 (GPIO0), U4.18 (B1)
P_A1: U1.2 (GPIO1), U4.17 (B2)
P_A2: U1.4 (GPIO2), U4.16 (B3)
P_A3: U1.5 (GPIO3), U4.15 (B4)
P_A4: U1.6 (GPIO4), U4.14 (B5)
P_A5: U1.7 (GPIO5), U4.13 (B6)
P_A6: U1.9 (GPIO6), U4.12 (B7)
P_A7: U1.10 (GPIO7), U4.11 (B8)
P_A8: U1.11 (GPIO8), U5.18 (B1)
P_A9: U1.12 (GPIO9), U5.17 (B2)
P_A10: U1.14 (GPIO10), U5.16 (B3)
P_A11: U1.15 (GPIO11), U5.15 (B4)
P_A12: U1.16 (GPIO12), U5.14 (B5)
P_A13: D3.2 (A), U1.17 (GPIO13), U5.13 (B6)
P_A15: U1.31 (GPIO26), U5.12 (B7)
P_BUSRESET_N: D6.2 (A), U7.15 (B4)
P_D0: U1.19 (GPIO14), U6.18 (B1)
P_D1: U1.20 (GPIO15), U6.17 (B2)
P_D2: U1.21 (GPIO16), U6.16 (B3)
P_D3: U1.22 (GPIO17), U6.15 (B4)
P_D4: U1.24 (GPIO18), U6.14 (B5)
P_D5: U1.25 (GPIO19), U6.13 (B6)
P_D6: U1.26 (GPIO20), U6.12 (B7)
P_D7: U1.27 (GPIO21), U6.11 (B8)
P_IORQ_N: D5.2 (A), U7.17 (B2)
P_ROMEN_N: R6.1, U1.29 (GPIO22), U7.18 (B1)
P_WR_N: D4.2 (A), U7.16 (B3)
RESET_PULLDOWN: D6.1 (K), U1.34 (GPIO28)
ROMDIS: JP2.4, R4.1; also elsewhere on the board
ROMEN_N: U7.2 (A1); also elsewhere on the board
ROM_LATCH: D3.1 (K), D4.1 (K), D5.1 (K), R5.1, U1.32 (GPIO27)
WR_N: U7.4 (A3); also elsewhere on the board

Notes on the sheet:
PICO 2 / RP2350 — ROM INTERFACE
3.3V B-side signals have P_ prefix. All CPC-facing GPIOs use level translation. Input switches enable when CPC 5V is present; JP2 separately isolates the data bus and controls ROMDIS.
Native RP2350 monitor: keep JP2 open. ROM-serving firmware and timing remain to be validated.
U4-U7 each require local 100nF. GPIO0/1 are address inputs: UART stdio must stay disabled.

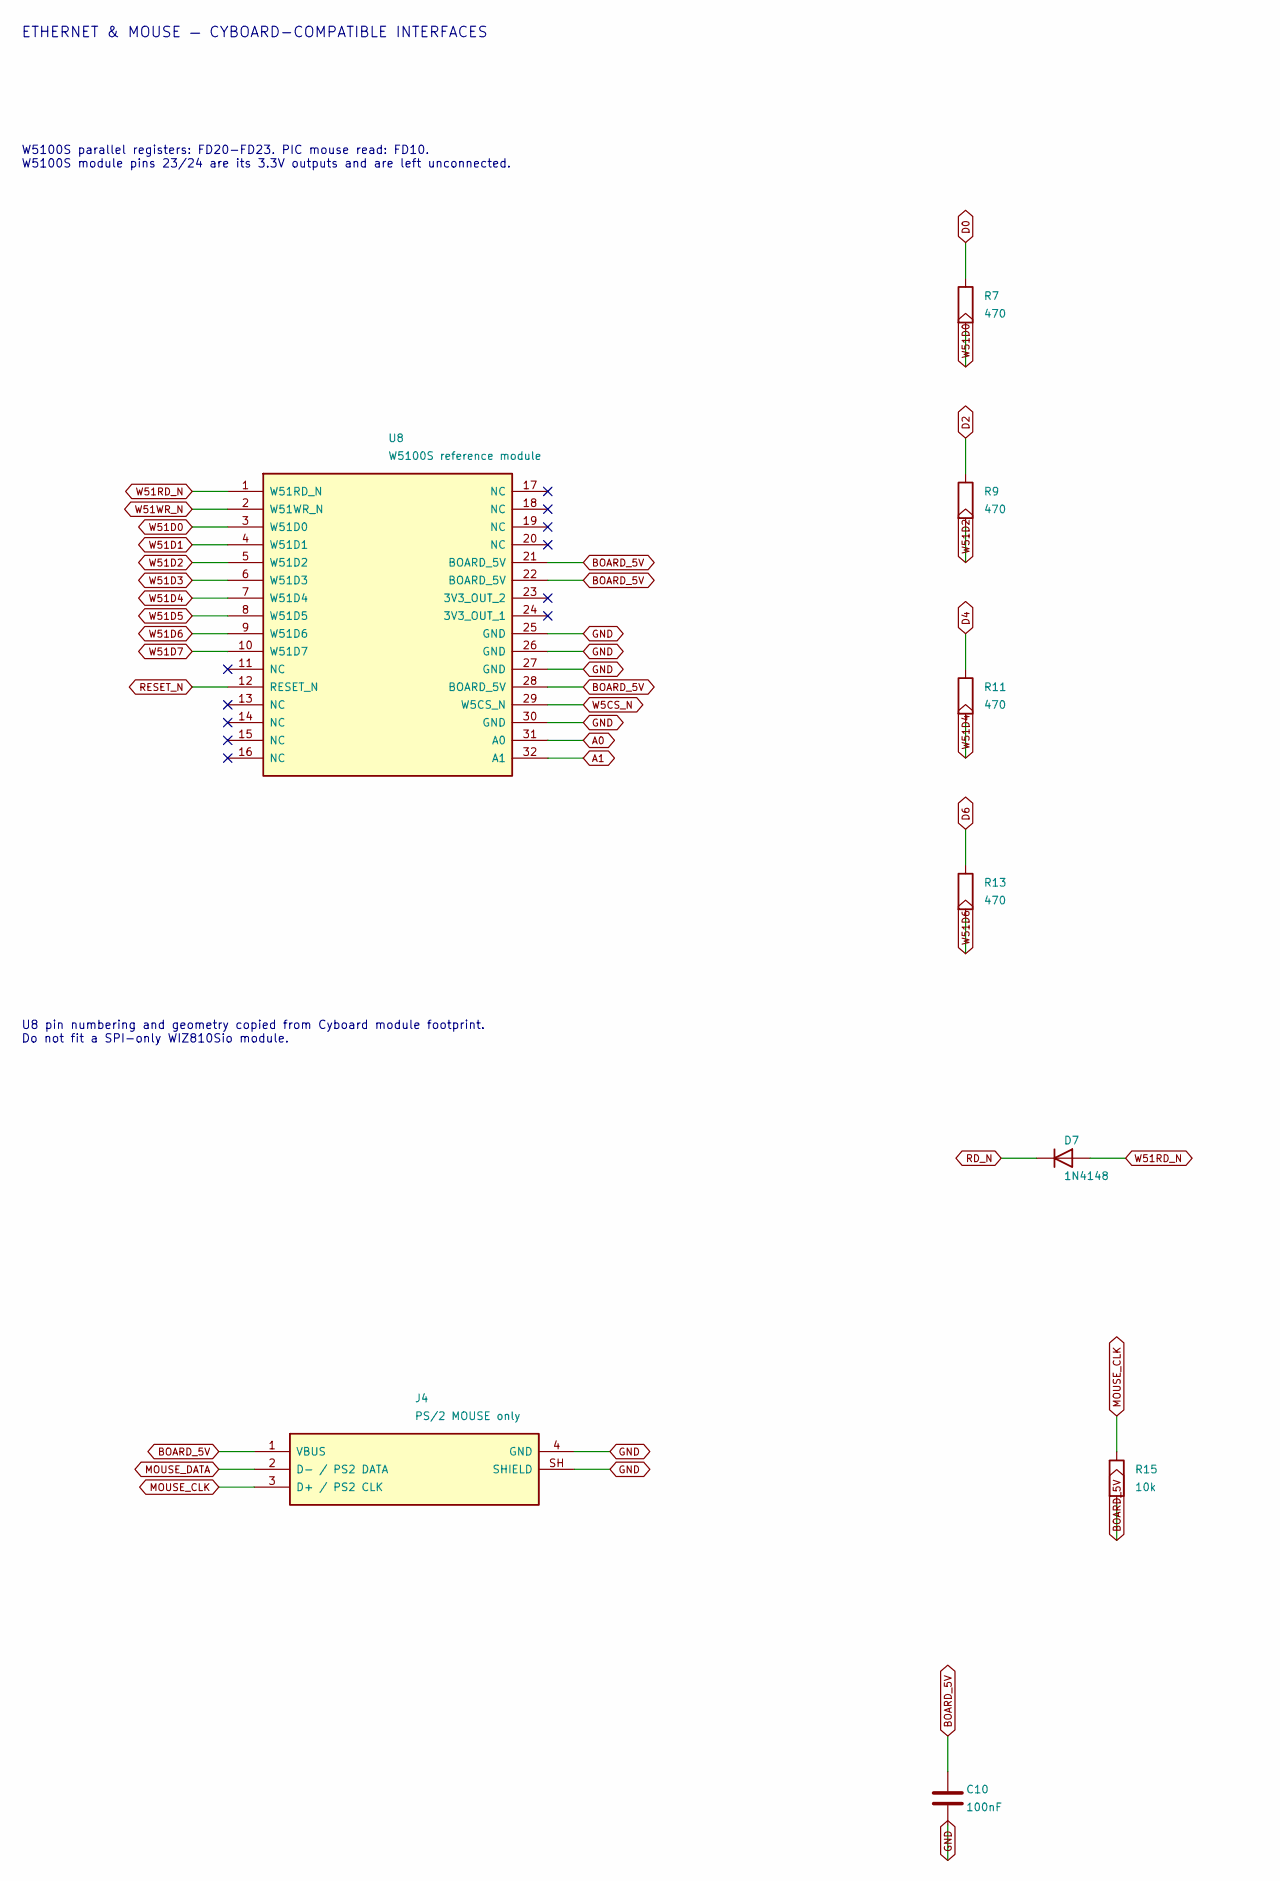
[picture p13: schematic ethernet-mouse.kicad_sch, Picolino CPC / ethernet-mouse, part in row 1, column 1]

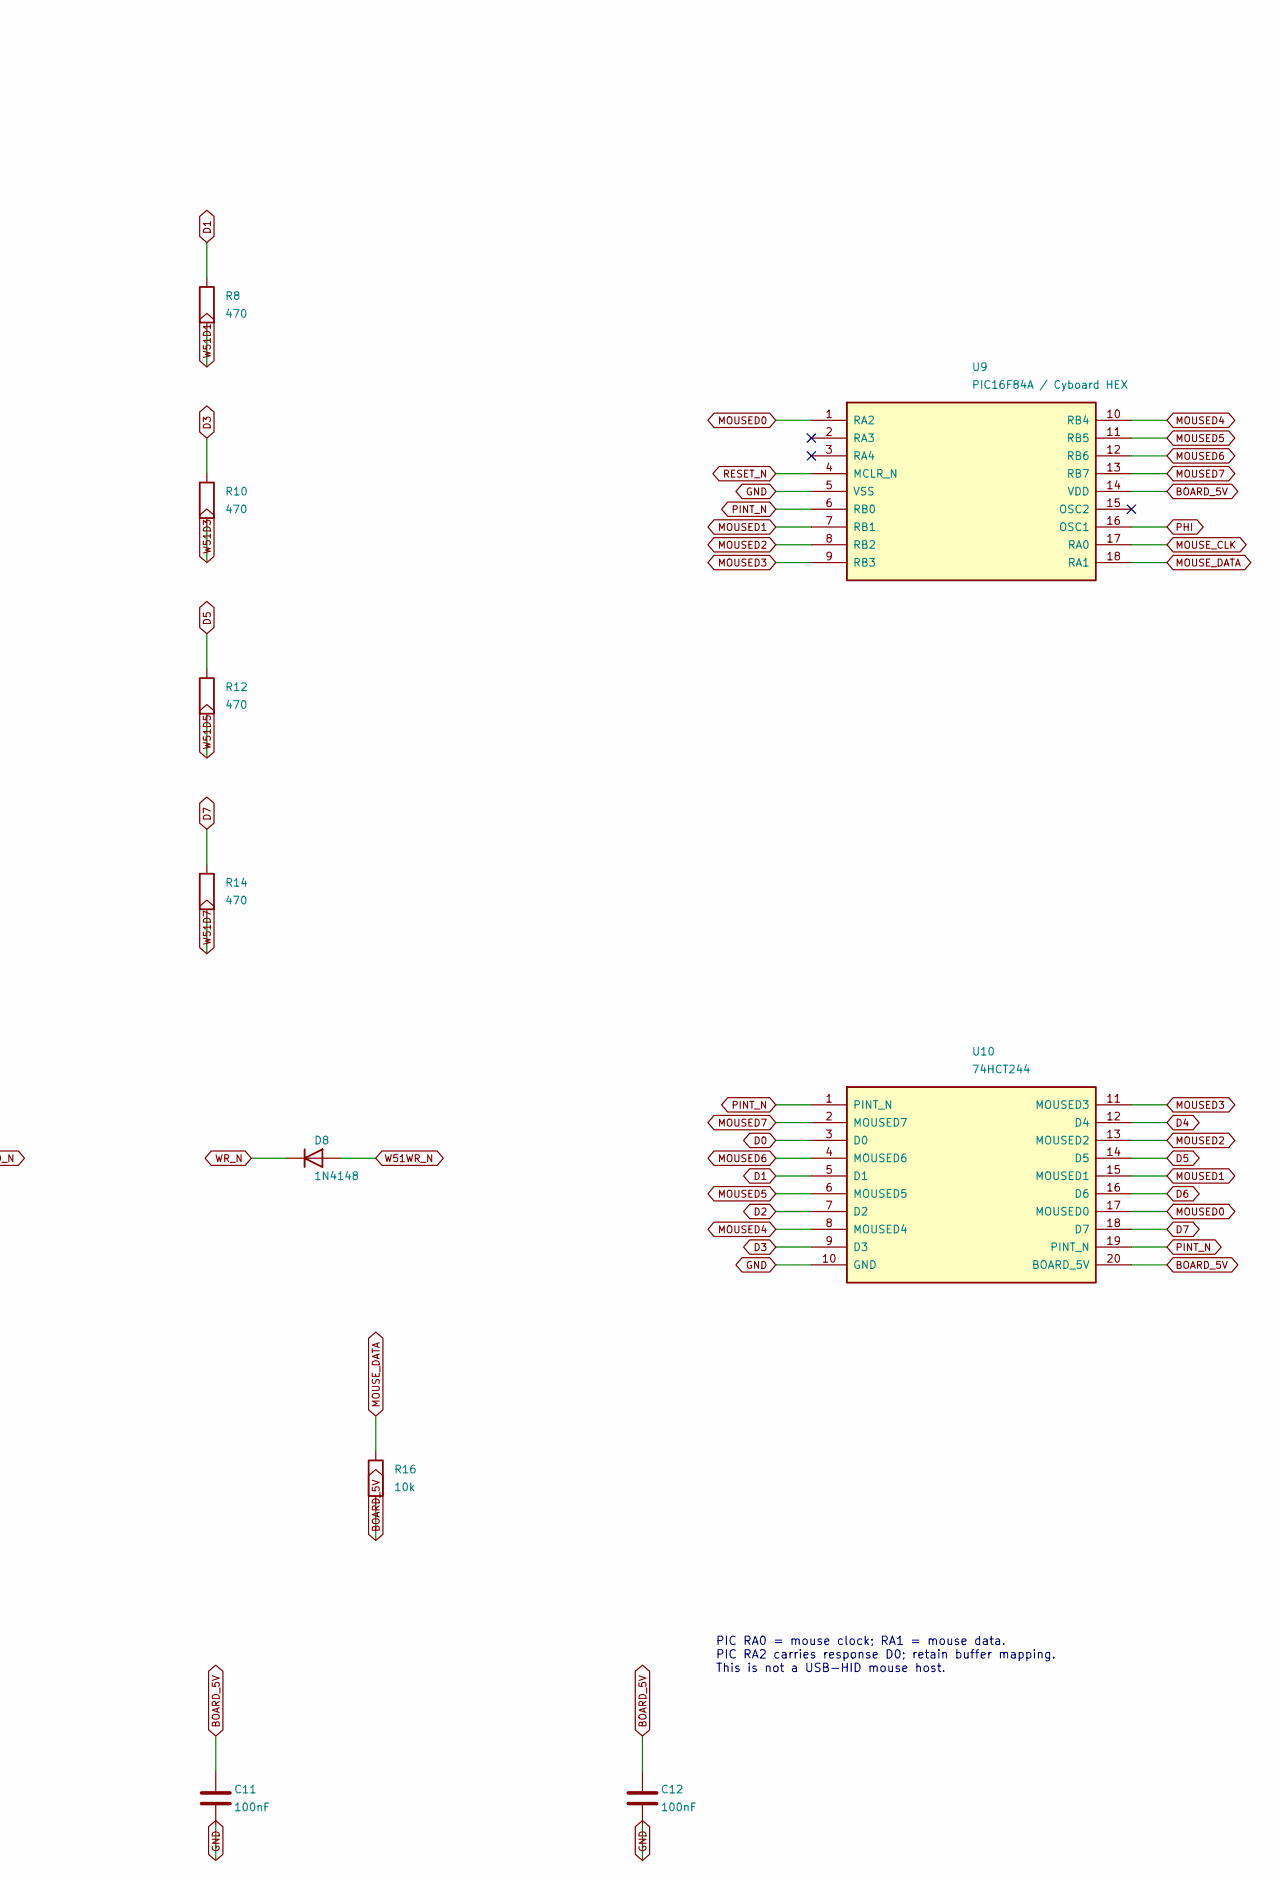
[picture p14: schematic ethernet-mouse.kicad_sch, Picolino CPC / ethernet-mouse, part in row 1, column 2]

Parts:
C10, C11, C12: 100nF; C_0805_2012Metric
D7, D8: 1N4148; D_DO-35_SOD27_P7.62mm_Horizontal
J4: PS/2 MOUSE only; USB_A_TE_292303-7_Horizontal
R7, R8, R9, R10, R11, R12, R13, R14: 470; R_0805_2012Metric
R15, R16: 10k; R_0805_2012Metric
U8: W5100S reference module; W5100S_Cyboard
U9: PIC16F84A / Cyboard HEX; DIP-18_W7.62mm_Socket_LongPads
U10: 74HCT244; DIP-20_W7.62mm_Socket_LongPads

Connections:
A0: U8.31 (A0); also elsewhere on the board
A1: U8.32 (A1); also elsewhere on the board
BOARD_5V: C10.1, C11.1, C12.1, J4.1 (VBUS), R15.2, R16.2, U8.21 (BOARD_5V), U8.22 (BOARD_5V), U8.28 (BOARD_5V), U9.14 (VDD), U10.20 (BOARD_5V); also elsewhere on the board
D0: R7.1, U10.3 (D0); also elsewhere on the board
D1: R8.1, U10.5 (D1); also elsewhere on the board
D2: R9.1, U10.7 (D2); also elsewhere on the board
D3: R10.1, U10.9 (D3); also elsewhere on the board
D4: R11.1, U10.12 (D4); also elsewhere on the board
D5: R12.1, U10.14 (D5); also elsewhere on the board
D6: R13.1, U10.16 (D6); also elsewhere on the board
D7: R14.1, U10.18 (D7); also elsewhere on the board
GND: C10.2, C11.2, C12.2, J4.4 (GND), J4.SH (SHIELD), U8.25 (GND), U8.26 (GND), U8.27 (GND), U8.30 (GND), U9.5 (VSS), U10.10 (GND); also elsewhere on the board
MOUSED0: U9.1 (RA2), U10.17 (MOUSED0)
MOUSED1: U9.7 (RB1), U10.15 (MOUSED1)
MOUSED2: U9.8 (RB2), U10.13 (MOUSED2)
MOUSED3: U9.9 (RB3), U10.11 (MOUSED3)
MOUSED4: U9.10 (RB4), U10.8 (MOUSED4)
MOUSED5: U9.11 (RB5), U10.6 (MOUSED5)
MOUSED6: U9.12 (RB6), U10.4 (MOUSED6)
MOUSED7: U9.13 (RB7), U10.2 (MOUSED7)
MOUSE_CLK: J4.3 (D+ / PS2 CLK), R15.1, U9.17 (RA0)
MOUSE_DATA: J4.2 (D- / PS2 DATA), R16.1, U9.18 (RA1)
PHI: U9.16 (OSC1); also elsewhere on the board
PINT_N: U9.6 (RB0), U10.1 (PINT_N), U10.19 (PINT_N); also elsewhere on the board
RD_N: D7.1 (K); also elsewhere on the board
RESET_N: U8.12 (RESET_N), U9.4 (MCLR_N); also elsewhere on the board
W5CS_N: U8.29 (W5CS_N); also elsewhere on the board
W51D0: R7.2, U8.3 (W51D0)
W51D1: R8.2, U8.4 (W51D1)
W51D2: R9.2, U8.5 (W51D2)
W51D3: R10.2, U8.6 (W51D3)
W51D4: R11.2, U8.7 (W51D4)
W51D5: R12.2, U8.8 (W51D5)
W51D6: R13.2, U8.9 (W51D6)
W51D7: R14.2, U8.10 (W51D7)
W51RD_N: D7.2 (A), U8.1 (W51RD_N)
W51WR_N: D8.2 (A), U8.2 (W51WR_N)
WR_N: D8.1 (K); also elsewhere on the board

Notes on the sheet:
ETHERNET & MOUSE — CYBOARD-COMPATIBLE INTERFACES
W5100S parallel registers: FD20-FD23. PIC mouse read: FD10. W5100S module pins 23/24 are its 3.3V outputs and are left unconnected.
U8 pin numbering and geometry copied from Cyboard module footprint. Do not fit a SPI-only WIZ810Sio module.
PIC RA0 = mouse clock; RA1 = mouse data. PIC RA2 carries response D0; retain buffer mapping. This is not a USB-HID mouse host.
