salvogendut/picolino-CPC/hardware/kicad/picolino-cpc.kicad_pcb

## KiCad design hardware/kicad/picolino-cpc.kicad_pcb (continued)

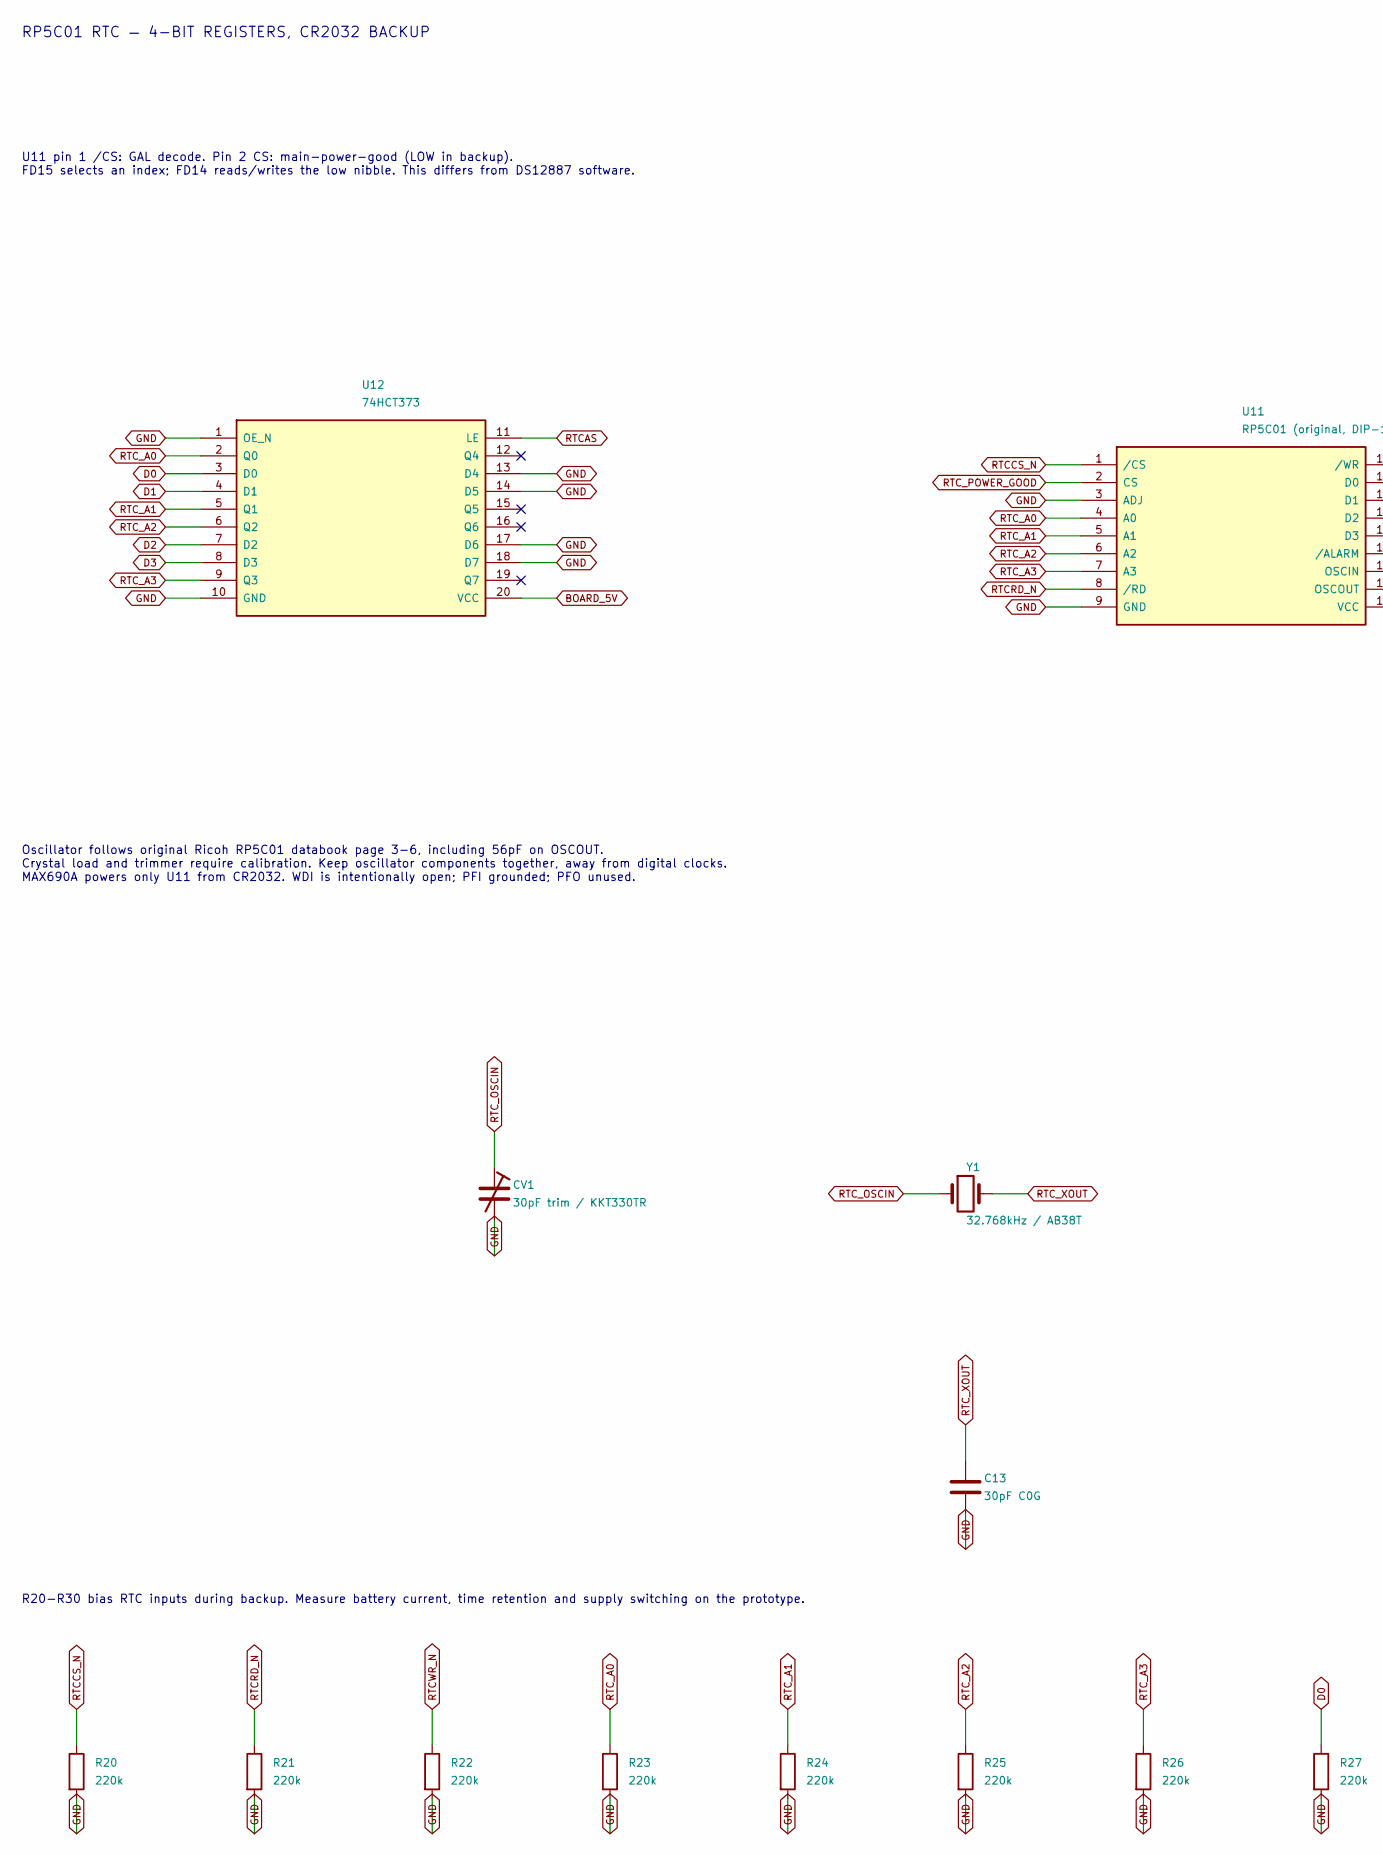
[picture p15: schematic rtc.kicad_sch, Picolino CPC / rtc, part in row 1, column 1]

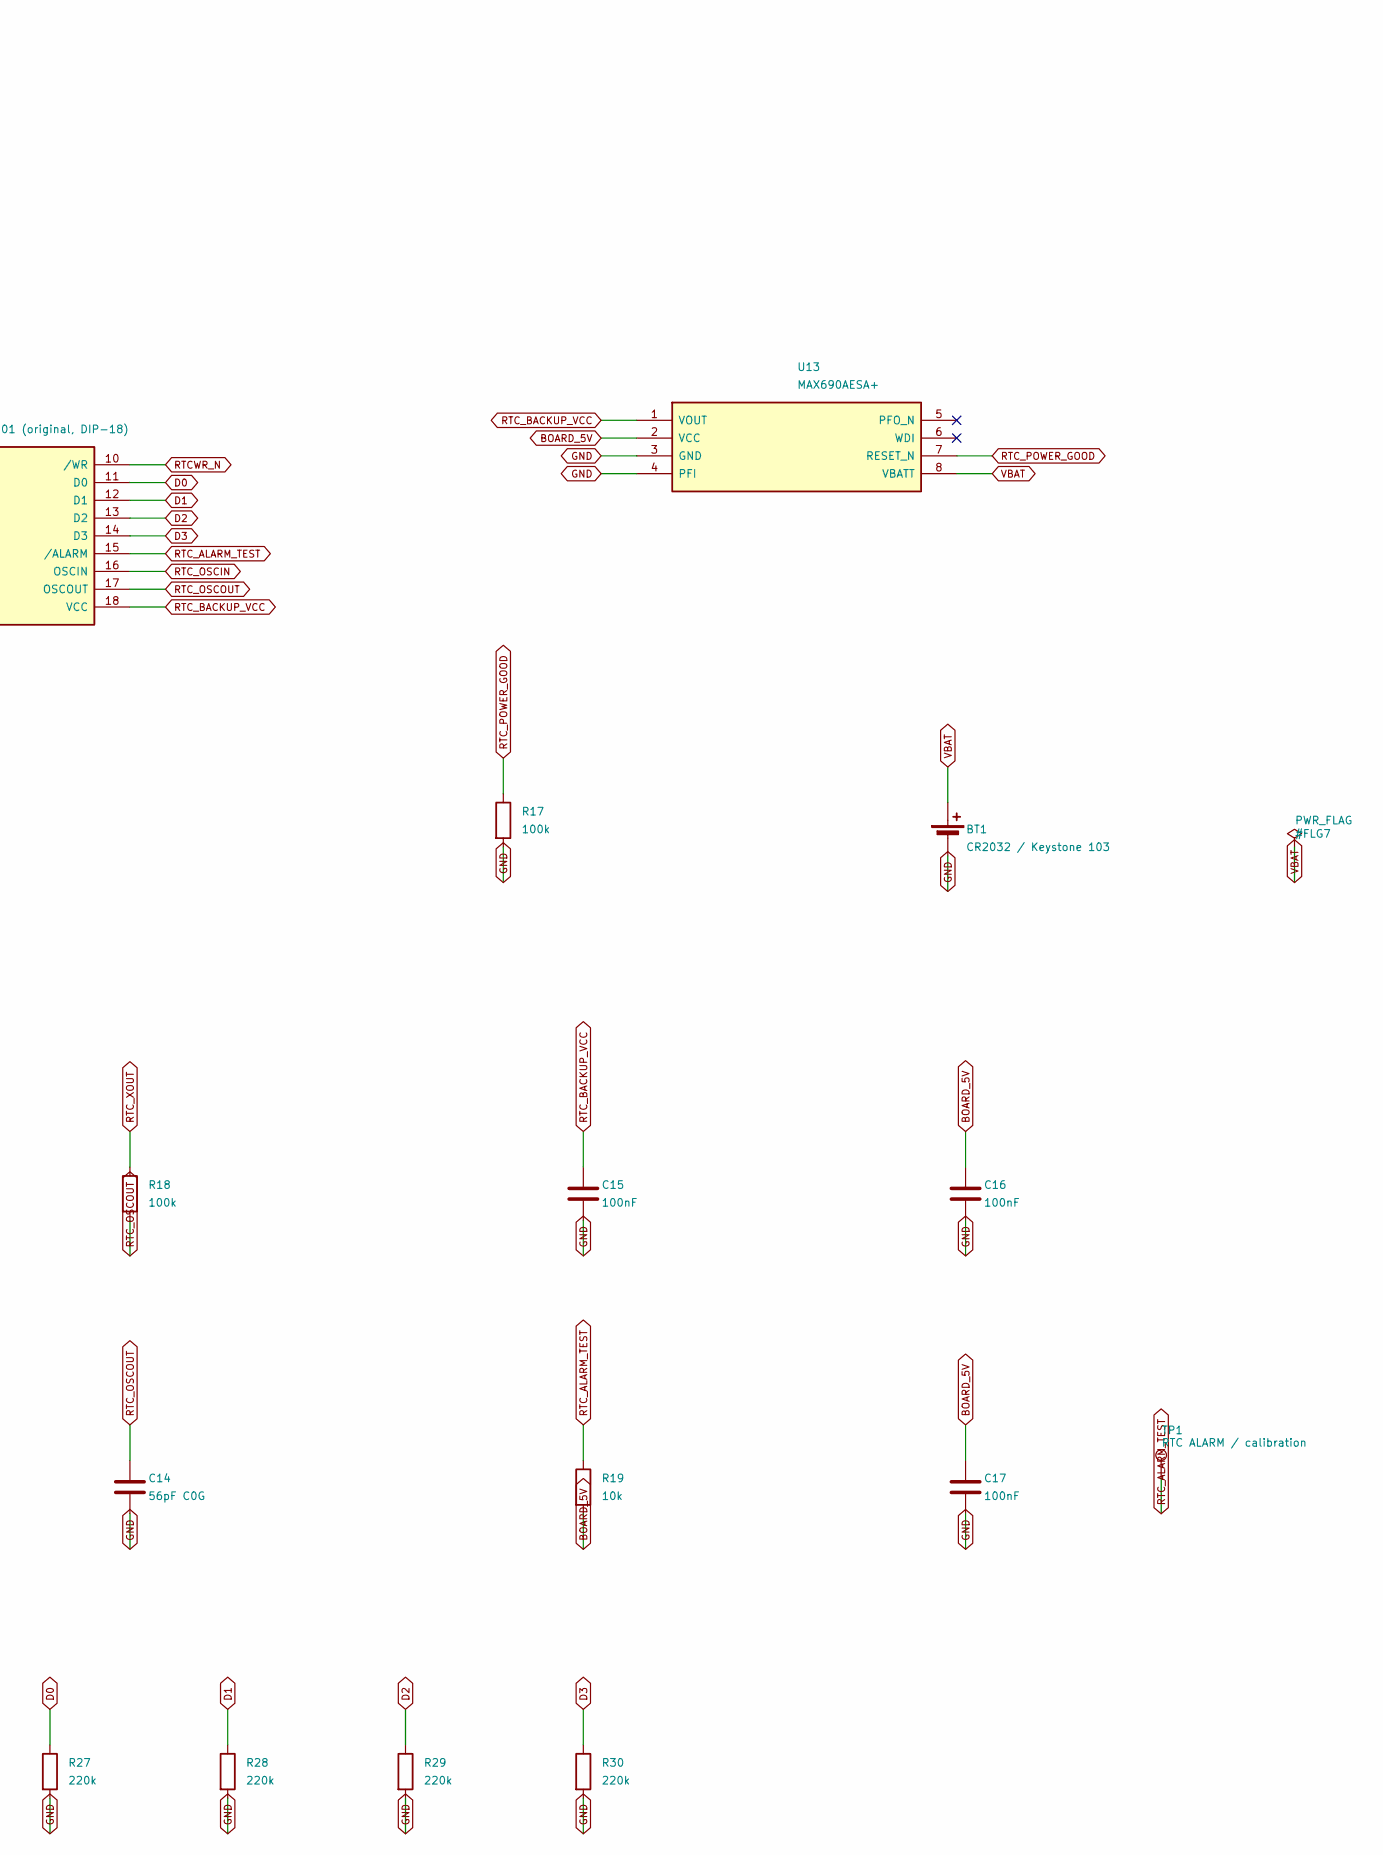
[picture p16: schematic rtc.kicad_sch, Picolino CPC / rtc, part in row 1, column 2]

Parts:
BT1: CR2032 / Keystone 103; BatteryHolder_Keystone_103_1x20mm
C13: 30pF C0G; C_0805_2012Metric
C14: 56pF C0G; C_0805_2012Metric
C15, C16, C17: 100nF; C_0805_2012Metric
CV1: 30pF trim / KKT330TR; C_Trimmer_Murata_TZC3
R17, R18: 100k; R_0805_2012Metric
R19: 10k; R_0805_2012Metric
R20, R21, R22, R23, R24, R25, R26, R27, R28, R29, R30: 220k; R_0805_2012Metric
TP1: RTC ALARM / calibration; TestPoint_THTPad_D2.0mm_Drill1.0mm
U11: RP5C01 (original, DIP-18); DIP-18_W7.62mm_Socket_LongPads
U12: 74HCT373; DIP-20_W7.62mm_Socket_LongPads
U13: MAX690AESA+; SOIC-8_3.9x4.9mm_P1.27mm
Y1: 32.768kHz / AB38T; Crystal_C38-LF_D3.0mm_L8.0mm_Vertical

Connections:
BOARD_5V: C16.1, C17.1, R19.2, U12.20 (VCC), U13.2 (VCC); also elsewhere on the board
D0: R27.1, U11.11 (D0), U12.3 (D0); also elsewhere on the board
D1: R28.1, U11.12 (D1), U12.4 (D1); also elsewhere on the board
D2: R29.1, U11.13 (D2), U12.7 (D2); also elsewhere on the board
D3: R30.1, U11.14 (D3), U12.8 (D3); also elsewhere on the board
GND: BT1.2 (-), C13.2, C14.2, C15.2, C16.2, C17.2, CV1.2, R17.2, R20.2, R21.2, R22.2, R23.2, R24.2, R25.2, R26.2, R27.2, R28.2, R29.2, R30.2, U11.3 (ADJ), U11.9 (GND), U12.1 (OE_N), U12.10 (GND), U12.13 (D4), U12.14 (D5), U12.17 (D6), U12.18 (D7), U13.3 (GND), U13.4 (PFI); also elsewhere on the board
RTCAS: U12.11 (LE); also elsewhere on the board
RTCCS_N: R20.1, U11.1 (/CS); also elsewhere on the board
RTCRD_N: R21.1, U11.8 (/RD); also elsewhere on the board
RTCWR_N: R22.1, U11.10 (/WR); also elsewhere on the board
RTC_A0: R23.1, U11.4 (A0), U12.2 (Q0)
RTC_A1: R24.1, U11.5 (A1), U12.5 (Q1)
RTC_A2: R25.1, U11.6 (A2), U12.6 (Q2)
RTC_A3: R26.1, U11.7 (A3), U12.9 (Q3)
RTC_ALARM_TEST: R19.1, TP1.1, U11.15 (/ALARM)
RTC_BACKUP_VCC: C15.1, U11.18 (VCC), U13.1 (VOUT)
RTC_OSCIN: CV1.1, U11.16 (OSCIN), Y1.1
RTC_OSCOUT: C14.1, R18.2, U11.17 (OSCOUT)
RTC_POWER_GOOD: R17.1, U11.2 (CS), U13.7 (RESET_N)
RTC_XOUT: C13.1, R18.1, Y1.2
VBAT: BT1.1 (+), U13.8 (VBATT)

Notes on the sheet:
RP5C01 RTC — 4-BIT REGISTERS, CR2032 BACKUP
U11 pin 1 /CS: GAL decode. Pin 2 CS: main-power-good (LOW in backup). FD15 selects an index; FD14 reads/writes the low nibble. This differs from DS12887 software.
Oscillator follows original Ricoh RP5C01 databook page 3-6, including 56pF on OSCOUT. Crystal load and trimmer require calibration. Keep oscillator components together, away from digital clocks. MAX690A powers only U11 from CR2032. WDI is intentionally open; PFI grounded; PFO unused.
R20-R30 bias RTC inputs during backup. Measure battery current, time retention and supply switching on the prototype.

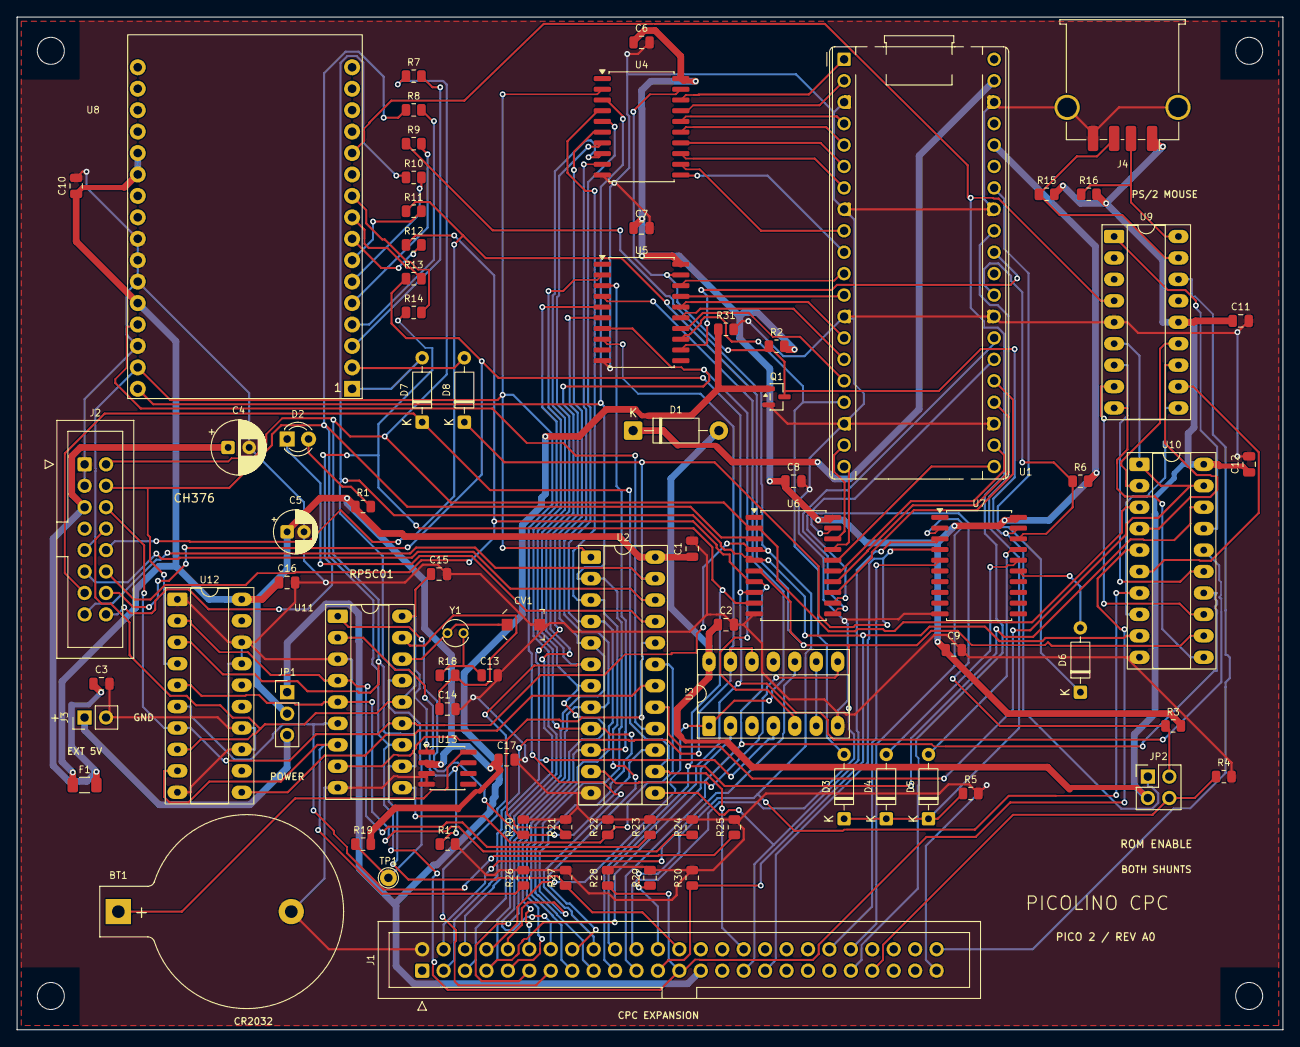
[picture p17: board picolino-cpc.kicad_pcb from above]

Board: 2 copper layers, 150.0 x 120.0 mm, 85 parts (0 on the bottom side), 112 nets.
