salvogendut/picolino-CPC/(commit log)

2026-10-07 Establish Pico 2 combined-board architecture and validated firmware baseline
2026-10-07 Add routed Picolino revision A0 KiCad prototype and 3D documentation
    [bom.csv, bus-power.kicad_sch, ethernet-mouse.kicad_sch, pico-rom.kicad_sch, picolino-cpc.kicad_pcb, picolino-cpc.kicad_sch, rtc.kicad_sch]
